GitHubLHAn/Final_DATN_LeHuuAn/Picture/Thực nghiệm/Sơ đồ nguyên lý vdk.png

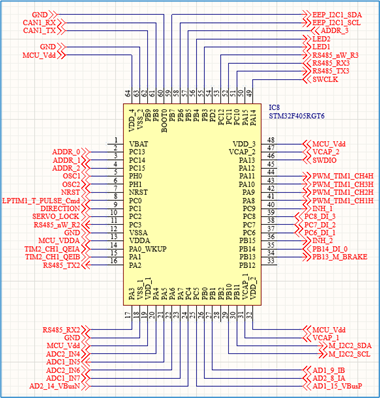
Picture/Thực nghiệm/Sơ đồ nguyên lý vdk.png
