GitHubLHAn/Final_DATN_LeHuuAn/Picture/Thực nghiệm/PCB mặt sau.png

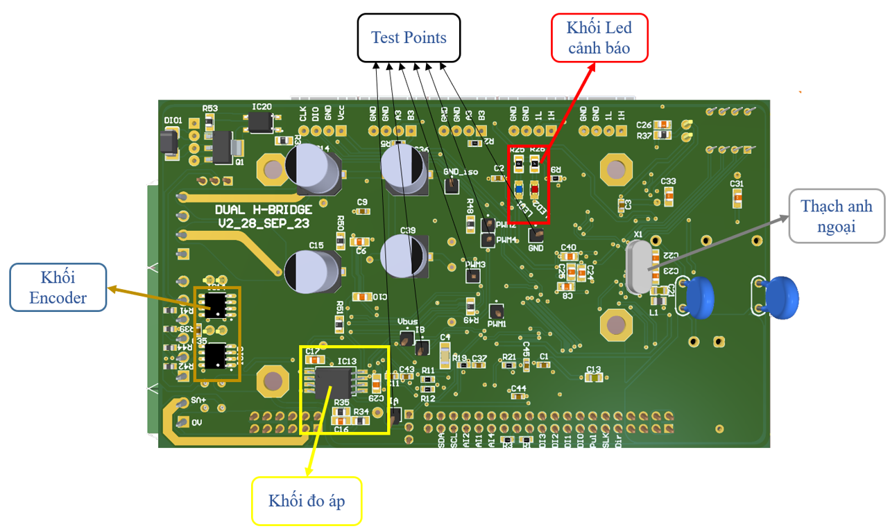
Picture/Thực nghiệm/PCB mặt sau.png
