GitHubLHAn/Final_DATN_LeHuuAn/README.md

# Final_DATN_LeHuuAn
Full final project at university
