GitHubLHAn/Final_DATN_LeHuuAn/Report/Graph_Handmade.pptx

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
North

South

Rotor

## Slide 2

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
North

South

Rotor

## Slide 3

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
North

South

Rotor

## Slide 4

Sin Wave

A

B’

B

A’

+

0

Phase A Current

+

0

Phase B Current

## Slide 5

Static Torque

Displacement from an Equilibrium position

Holding Torque

0

θ_m

θ

## Slide 6

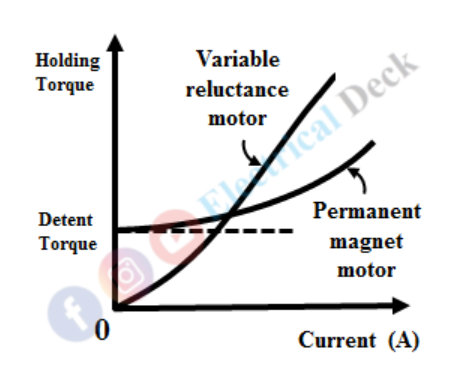
[picture p3: figure]

Holding Torque

Detent Torque

0

Current (A)

## Slide 7

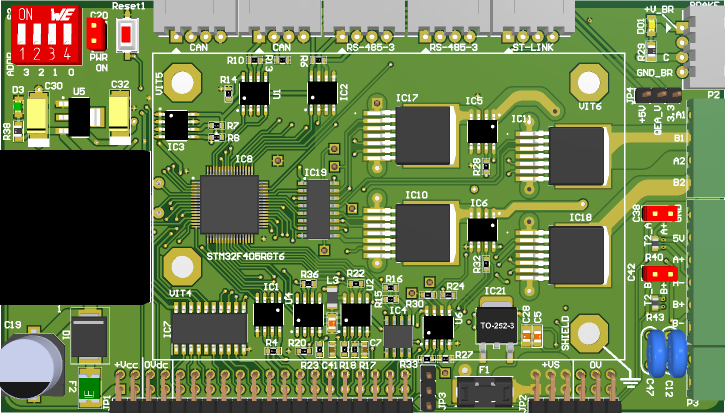
[picture p4: figure]
PCB_5A_HYBRID_SERVO_V3_04_Oct_23

## Slide 8

Mạch điều khiển động cơ

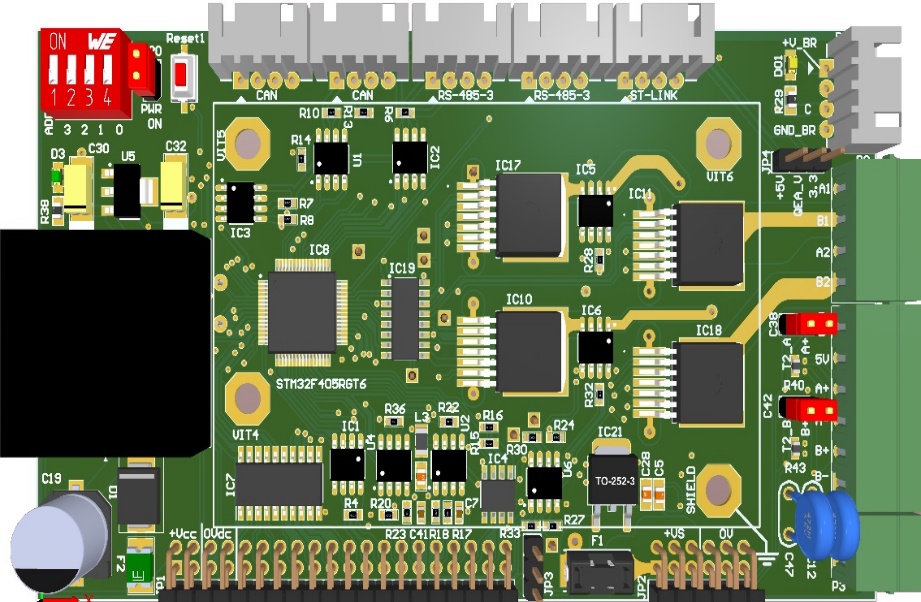
[picture p5: figure]
Ảnh có chứa đồ điện tử, mạch điện, Linh kiện điện, Thành phần mạch điện Mô tả được tạo tự động
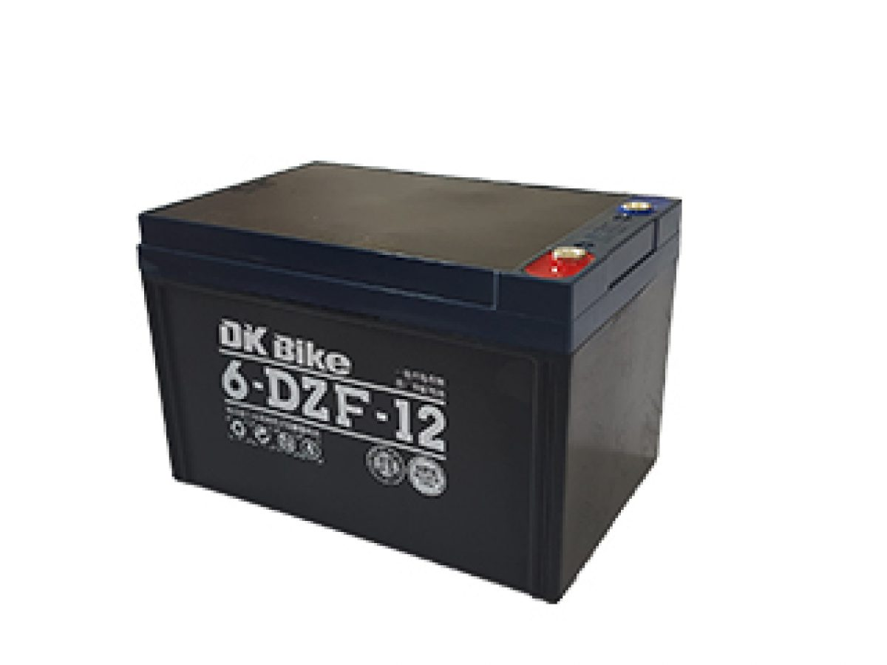
[picture p6: figure]
ẮC QUY XE ĐẠP ĐIỆN DK BIKE 48V - 12AH - Ắc quy nhập khẩu

Pin acqui

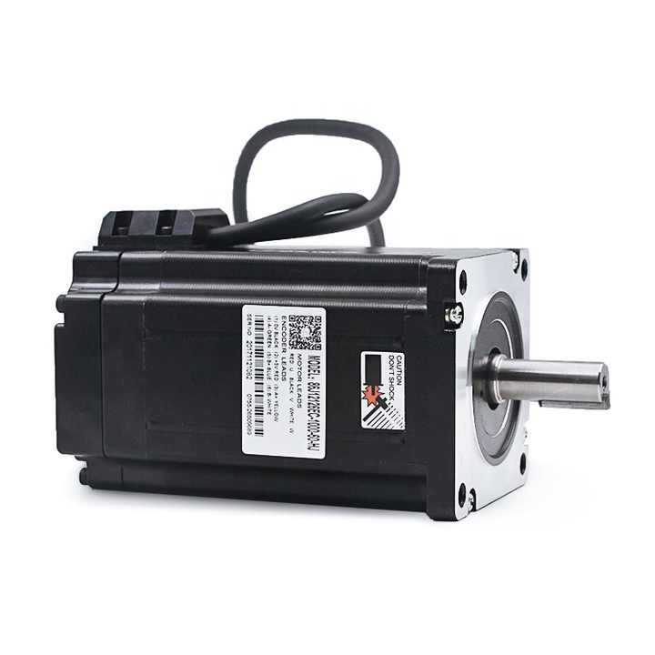
[picture p7: figure]
Source 86J12126EC-1000-60 Động Cơ Servo Bước Hỗn Hợp 1.2 Độ 7.8 N. M Động Cơ Bước Vòng Kín Với Trình Điều Khiển on m.alibaba.com

Hybrid Step Motor

A+

A-

B+

B-

EGND

EA+

EA-

5V

24 Vdc

EB+

EB-

0 Vdc

## Slide 9

Khối Vi Điều Khiển

RS-485

St-Link V2

Khối đo dòng

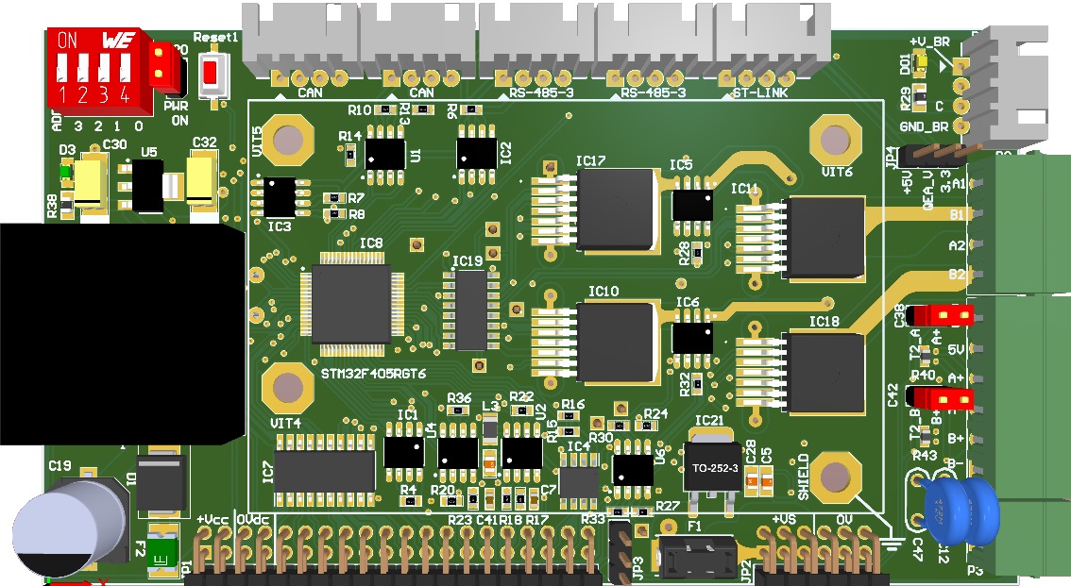
[picture p8: figure]
Ảnh có chứa đồ điện tử, mạch điện, Linh kiện điện, Thành phần mạch điện Mô tả được tạo tự động

Khối nguồn

Đầu ra điện áp động cơ

Cầu đấu Encoder tương đối

Đầu vào ra Analog, I2C,...

Cầu chì phía mạch lực

Khối Driver

## Slide 10

Test Points

Khối Led cảnh báo

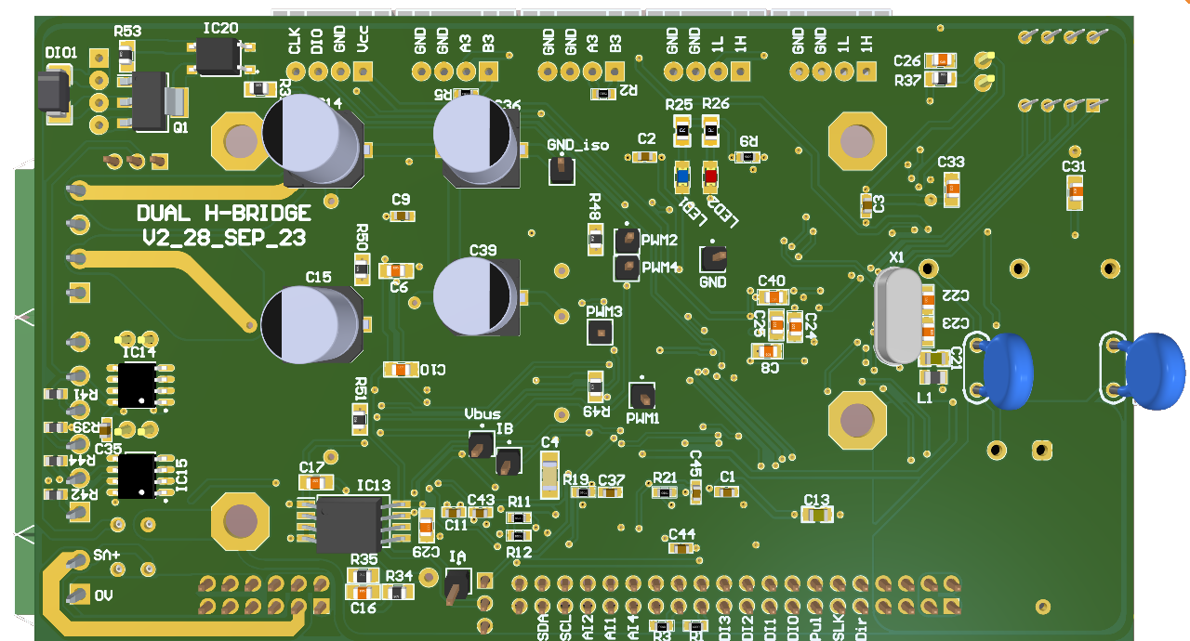
[picture p9: figure]
Ảnh có chứa mạch điện, Kỹ thuật điện, Linh kiện điện, Thành phần mạch điện Mô tả được tạo tự động

Thạch anh ngoại

Khối Encoder

Khối đo áp

## Slide 11

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
## Slide 12

In its simplest form, a step motor consists of a permanent magnet which rotates (the rotor), surrounded by equally spaced windings which are fixed (the stator). Current flow in each winding produces a magnetic field vector, which sums with the field from the other winding. By controlling currents in each winding, a magnetic field of arbitrary direction and magnitude can be produced by the stator. Torque is then produced by the attraction or repulsion between this net stator field and the magnetic field of the rotor.
In field oriented control, the motor input currents are adjusted to set a specific angle between the fluxes produced in the rotor and stator windings. The key to field oriented control is the knowledge of the rotor flux position angle with respect to the stator. The angle between the stator and rotor flux is computed from shaft position. For any position
of the rotor, there is an optimal direction of the net stator field, which maximizes torque; there is also a direction which will produce no torque. If the permanent magnet rotor is in the same direction as the field produces the net stator field, no torque is produced. The fields interact to produce a force, but because the force is in line with the axis of rotation of the rotor, it only serves to compress the motor bearings, not to cause rotation. On the other hand, if the stator field is orthogonal to the field produced by the rotor, the magnetic forces work to turn the rotor and torque is maximized. A stator field with arbitrary direction and magnitude can be decomposed into components parallel and orthogonal to the rotor field. In this case, only the orthogonal (quadrature) component produces torque, while the parallel component produces useless compression forces. For the purpose of control system modeling and analysis, it is convenient to work in terms of winding currents rather than stator magnetic field. This is because motor currents are easily measured externally while fields (flux) are not.
In a step motor, the stator field is produced by current flow in two equally spaced stator windings. These two components sum to produce the net magnetic field of the stator. In order to model the field produced by the stator windings in terms of winding current, ‘current space vectors’ are used. The current space vector for a given winding
has the direction of the field produced by that winding and a magnitude proportional to the current through the winding. This will represent the total stator field as a current space vector that is the vector sum of two current space vector components, one for each of the stator windings.

## Slide 13

The stator current space vector can be broken into orthogonal components in parallel with, and perpendicular to, the axis of the rotor magnet. The quadrature current component produces a field at right angles to the rotor magnet and therefore results in torque, while the direct current component produces a field that is aligned with the rotor magnet and therefore produces no torque. Winding currents will be adjusted so as to produce a current space vector that lies exclusively in the quadrature direction. Torque will then be proportional to the magnitude of the current space vector.
In order to efficiently produce constant smooth torque, the stator space vector should ideally be constant in magnitude and should turn with the rotor so as to always be in the quadrature direction, irrespective of the rotor angle and speed. While the stator current space vector may be constant in magnitude and direction if viewed form the rotating frame of reference of the rotor, from the fixed frame of the stator the current space vector describes a circle as the motor turns. Because the current space vector is produced by the vector sum of components from each of the motor windings, the motor winding currents should ideally be two sinusoids, phase shifted 90 0 from the each other. If winding A and B currents are sine waves phased 90 0 with respect to each other, then the resulting stator magnetic field vector will rotate at the sinusoidal frequency.

## Slide 14

Despite recent performance improvements in step motor modeling and control algorithms, open-loop control still falls significantly short of achieving maximum motor performance. Step motors, which are often used in industrial applications, can exhibit stepping resonance and skipped steps. Field oriented control can eliminate resonance anomalies and skipped steps. The maximum theoretical performance from the step motor can be derived by driving a step motor with field oriented control rather than stepping. In field oriented control, the motor input currents are adjusted to set a specific angle between the stator magnetic field and rotor magnetic field. From basic motor theory, when the stator magnetic field vector is maintained at a phase angle of 90 0 ahead of the rotor magnetic field, maximum torque is produced. The torque varies with the sine of this torque angle between the stator and rotor magnetic field vectors. By sensing rotor position, the phase of the rotor magnetic field can be determined and the current excitation kept 90 0 ahead of it. At this optimal torque angle, maximum torque is available (for given power supply voltage) under steady-state and transient operation. This approach is not widespread because electronic components historically have constrained drives to simple schemes such as stepping, and the full dynamic theory of electric machines was not worked out until the 1980’s. The resulting performance advantages of field oriented control over stepping compensate for the additional circuit cost and complexity.

## Slide 15

emf_a

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
emf_b

x

−

sin

## Slide 16

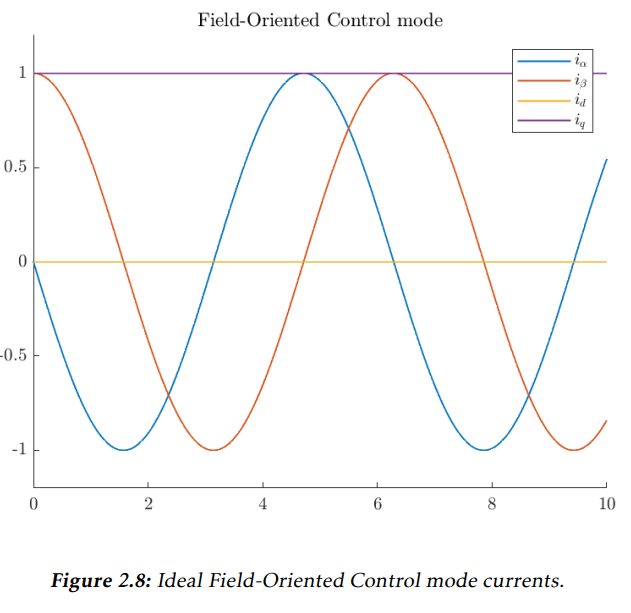
[picture p10: figure]
Ảnh có chứa văn bản, hàng, Sơ đồ, biểu đồ Mô tả được tạo tự động

Holding Torque

i_α

i_β

i_d

i_q

0

## Slide 17

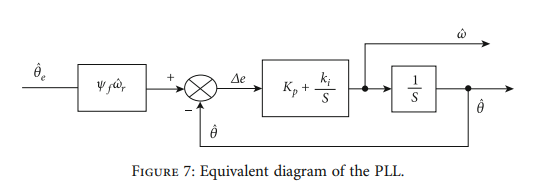
[picture p11: figure]
Ảnh có chứa biểu đồ, bản phác thảo, Phông chữ, Bản vẽ kỹ thuật Mô tả được tạo tự động

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
θ^(∗)

+

PI

1/s

ω

_

θ

## Slide 18

T_s

T_0 /4

T_2 /2

T_1 /2

T_0 /4

T_0 /4

T_1 /2

T_2 /2

T_0 /4

PWMa

PWMb

PWMc

PWMd

Sector I

T_s

T_0 /4

T_2 /2

T_1 /2

T_0 /4

T_0 /4

T_1 /2

T_2 /2

T_0 /4

PWMa

PWMb

PWMc

PWMd

Sector III

T_s

T_0 /4

T_2 /2

T_1 /2

T_0 /4

T_0 /4

T_1 /2

T_2 /2

T_0 /4

PWMa

PWMb

PWMc

PWMd

Sector II

T_s

T_0 /4

T_2 /2

T_1 /2

T_0 /4

T_0 /4

T_1 /2

T_2 /2

T_0 /4

PWMa

PWMb

PWMc

PWMd

Sector IV

## Slide 19

ω^(∗)

+

PI
Controller

i_s^(∗)

Cal

i_q^(∗)

+

−

PI

V_q^(∗)

dq

αβ

V_α^(∗)

Inverter

A +

A -

Hybrid
Step
Motor

V_(ph)

I_(ph)

ω

−

ω

i_d^(∗)

+

−

PI

V_d^(∗)

V_β^(∗)

B +

B -

θ

i_d

αβ

dq

i_q

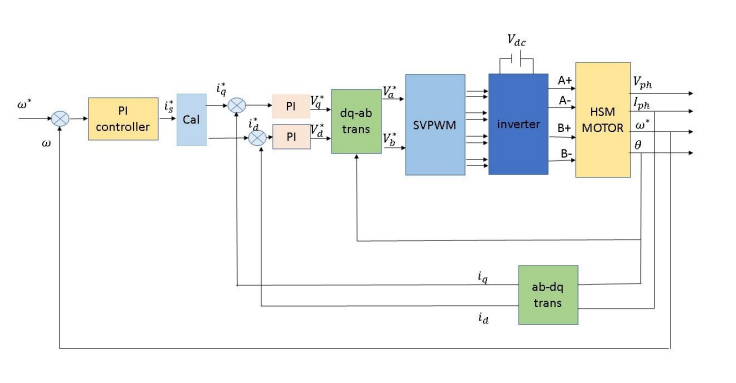
[picture p12: figure]
Ảnh có chứa văn bản, biểu đồ, Kế hoạch, Hình chữ nhật Mô tả được tạo tự động

## Slide 20

Phép tính dòng

i_q^(∗)

+

V_q^(∗)

V_d^(∗)

V_α^(∗)

A +

Động cơ bước lai

V_(ph)

ω^(∗)

+

−

ω

PI

i_s^(∗)

i_d^(∗)

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
V_β^(∗)

Điều chế SVPWM

Mạch Cầu H kép

A -

B +

θ

I_(ph)

ω

−

+

+

emf_d

B -

Ước lượng EMF

emf_q

i_d

αβ

dq

i_q

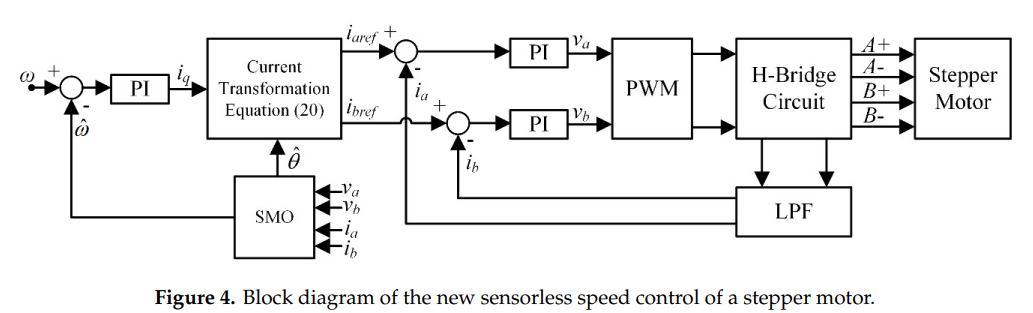
[picture p13: figure]

## Slide 21

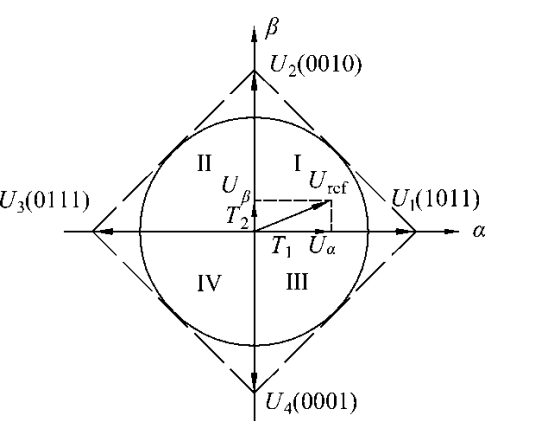
[picture p14: figure]
Ảnh có chứa biểu đồ, hàng, Phông chữ Mô tả được tạo tự động

β

U_2 (0010)

II

U_β

I

U_(ref)

U_3 (0111)

III

T_2

I V

T_1

U_α

U_1 (1011)

α

U_4 (0001)

## Slide 22

i_a^(∗)

V_α^(∗)

Điều chế SVPWM

Mạch Cầu H kép

A +

Động cơ bước lai

ω^(∗)

+

−

ω

PI

i_q^(∗)

Bộ biến đổi dòng điện

i_b^(∗)

Bộ điều khiển trượt (SMC)

V_β^(∗)

A -

B +

B -

θ

i_a

Vòng khóa pha (PLL)

emf_b

emf_a

i_b

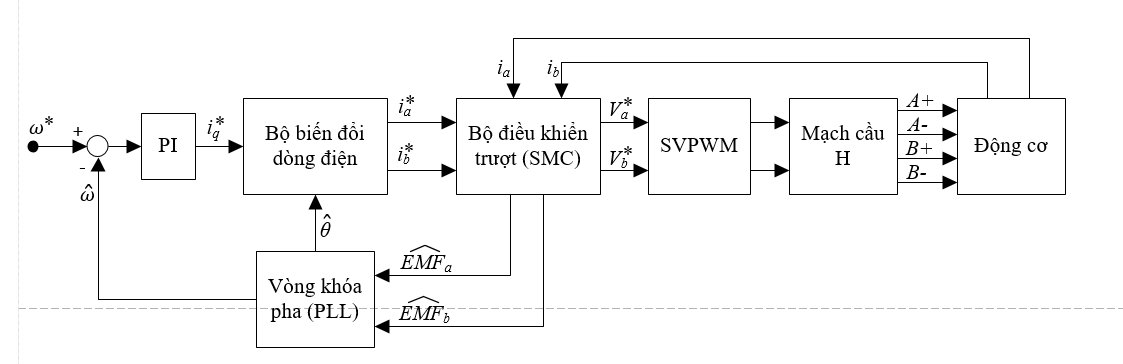
[picture p15: figure]

## Slide 23

x^(∗)

+

R(p)

S_0 (p)

x

−

Hệ thống theo chuẩn tối ưu module

R(s)

PI

S_0 (s)

ω

ω^(∗)

+

−

1/(T_D s+1)

(K_m)/(s.J+B)

Cấu trúc PI cho mạch vòng tốc độ

## Slide 24

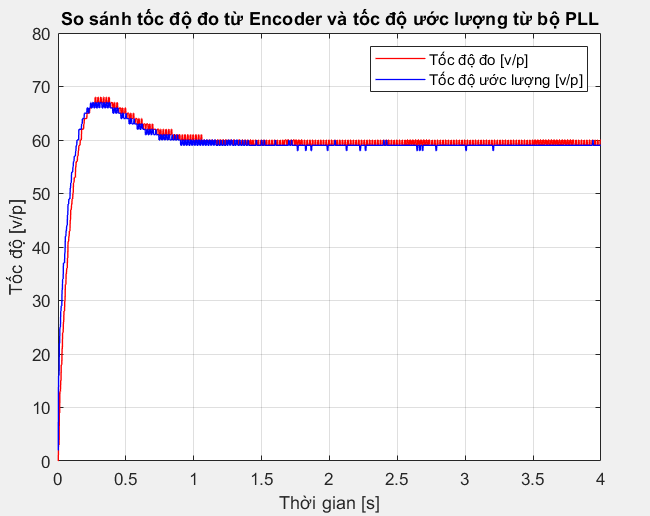
[picture p16: figure]
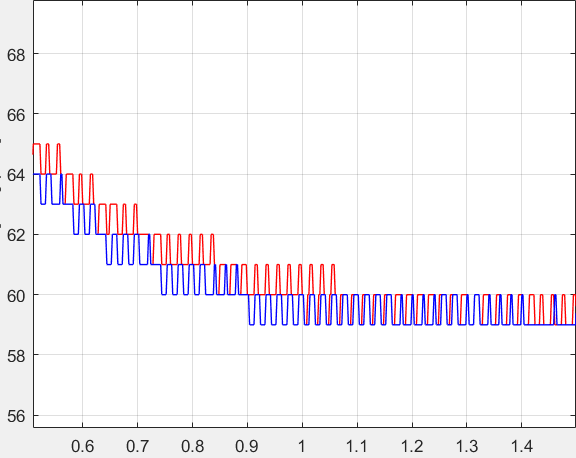
[picture p17: figure]

## Slide 25

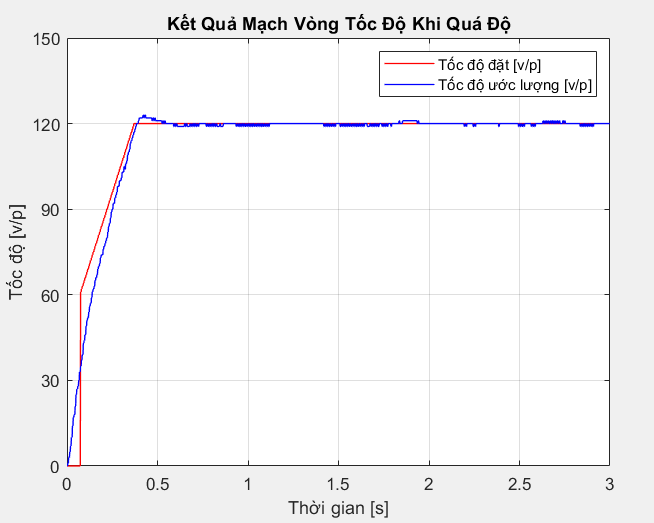
[picture p18: figure]
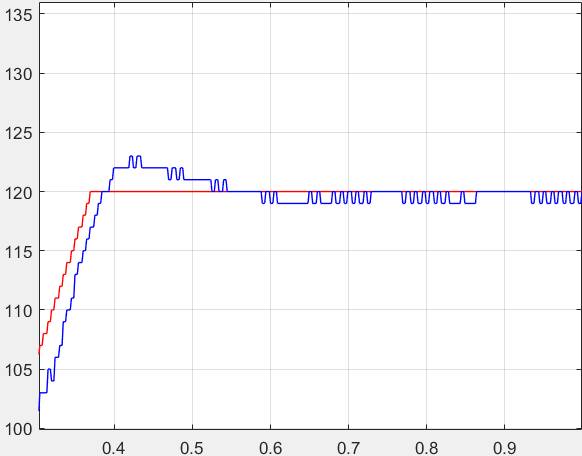
[picture p19: figure]

## Slide 26

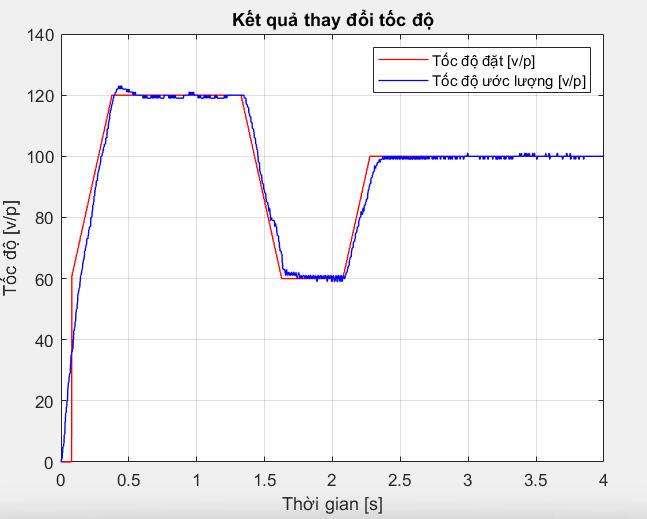
[picture p20: figure]
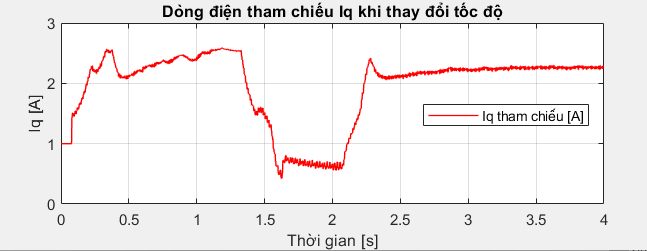
[picture p21: figure]

## Slide 27

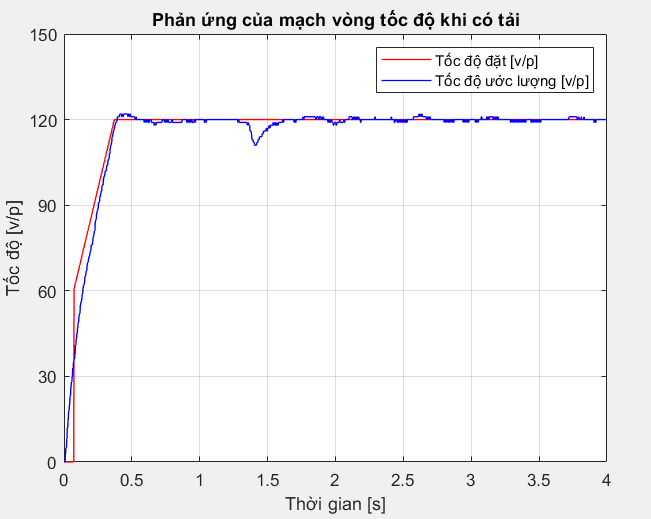
[picture p22: figure]
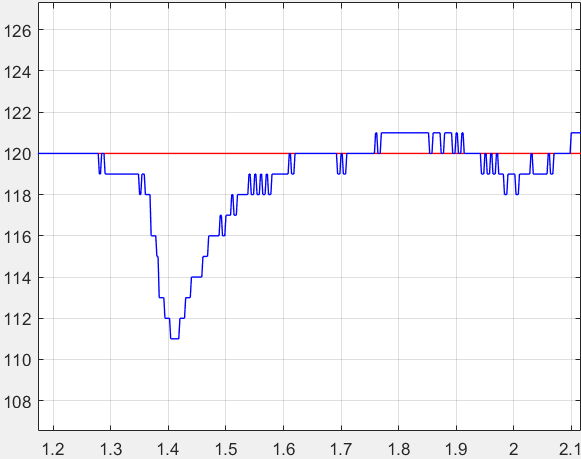
[picture p23: figure]
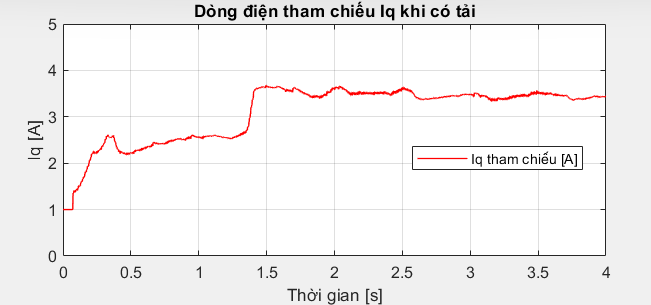
[picture p24: figure]

## Slide 28

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
## Slide 29

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
Cực nam

Cực bắc

Rotor

## Slide 30

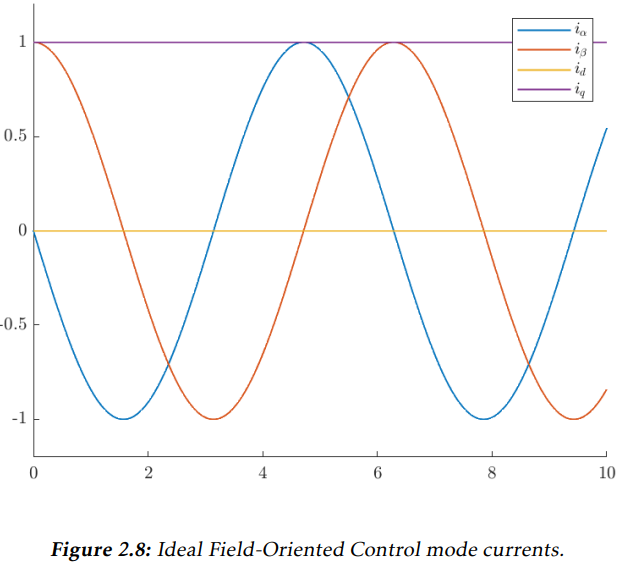
[picture p25: figure]
Ảnh có chứa văn bản, hàng, Sơ đồ, biểu đồ Mô tả được tạo tự động

## Slide 31

## Slide 32

## Slide 33

## Slide 34

## Slide 35
