GitHubLHAn/Final_DATN_LeHuuAn/Code versions/Research/Model_Free/JASE_ModelFreeControlOfOmnidirectionalRobot_V120923.pdf

Submission for JASE

Trajectory Tracking Control of Omnidirectional Mobile Robots: a

Model-Free Control-based Apprroach

Pham Anh Tuan¹ and Nguyen Manh Linh², *

1Hanoi University of Science and Technology. E-mail:tuan.pa192147@sis.hust.edu.vn

2, *Hanoi University of Science and Technology. E-mail: linh.nguyenmanh@hust.edu.vn

Controlling the motion of mobile robots, especially those equipped with Mecanum wheels is challenging due to the existence of disturbances and model uncertainties. In this paper, instead of trying to build a precise model for control design, the model-free control which replaces all the unknown complex mathematical parts with an ultra-local model is chosen. Then, an iPDSMC controller that combines the classical iPD and a double power rate sliding mode controller is proposed to improve the control system performance. The proposed strategy guarantees that even with a low bandwidth extended state observer used to continuously update the unknown parts of the plant, the tracking performance is maintained. The effectiveness of the proposed strategy is verified by both theoretical analysis and numerical simulations

Keywords: Omnidirectional mobile robot; Model-free control; Ultra-local model; Extended-state observer; Sliding mode

control

1

2 | 1. INTRODUCTION
3 | Mobile robots, particularly the omnidirectional ones that are equipped with Mecanum wheels,
4 | have gained widespread adoption in various industries due to their exceptional capabilities.
5 | These robots offer significant advantages, making them highly desirable for numerous appli-
6 | cations. The Mecanum wheel-based mobile robots possess true omnidirectional capabilities,
7 | allowing them to move in multiple directions with ease. This exceptional maneuverability
8 | enables them to navigate through narrow spaces and crowded environments, where conven-
9 | tional wheeled robots would struggle. By effortlessly moving forward, backward, sideways,

Table 1. List of Abbreviations

Abbreviation | Full Form
4-MWMR | Four Mecanum Wheeled Mobile Robot
MPC | Model Predictive Control
MFC | Model Free Control
SMC | Sliding Mode Control
iPD | Intelligent Proportional-Derivative
iPDSMC | Intelligent Proportional-Derivative Sliding Mode
| Control
ULM | Ultra-local Model
ULMFC | Ultra-local Model-free Control
ESO | Extended state observe
LESO | Linear Extended state observe

and even rotating in tight areas, these robots excel in optimizing productivity and efficiency.

These exceptional capabilities have led to the widespread adoption of mobile robots equipped

with Mecanum wheels in various industries, where their applications have been notably

pronounced. These robots have proven to be immensely valuable in warehouse automation

[1], hospital logistics [2], services [3], industrial field [4],. . .

With such practical applications as mentioned above, trajectory tracking has become a

fundamental and essential problem in mobile robot motion control, drawing significant

attention in the field of mobile robot research. Accurate trajectory tracking is of utmost

importance for 4-MWMR, as it directly reflects the effectiveness and performance of the

tracking process.

In literature, control strategies can be roughly categorized into two main types: model-

based and model-free approaches. Model-based control methods rely on mathematical models that describe the dynamics or kinematics of the system being controlled. Based on

the kinematic model, several research papers have proposed control strategies for Mecanum

mobile robots such as PID controller in [5–7] or LQR in [8]. It is worth mentioning that while

the kinematic model-based control strategies provide simplified representations of the robot’s

motion, they disregard the effects of inertia and motor torque limitations, assuming that the

desired velocities will be precisely and instantaneously achieved. However, in the case of

heavier robots or those with less powerful actuators, relying solely on a kinematic controller

may not be adequate. These robots may require additional time to accelerate or may be

limited by their actuator capabilities. Due to the limitations of the kinematic model, many

researchers have developed controllers based on the dynamic model. Prominent examples of

control strategies based on the dynamic model include: MPC controller [9–12], backstepping

control [13–15], and sliding mode control. While the MPC controller can provide robustness

against the model uncertainties and disturbances, it requires an accurate mathematical model

of the plant. And it is important to note that SMC can introduce chattering phenomena,

characterized by high-frequency oscillations around the sliding surface. This chattering effect

can result in increased wear and tear on the actuators and potentially affect the overall system

stability and performance. Numerous studies have been conducted to reduce and eliminate

chattering associated with controlling the 4-MWMR such as super-twisting sliding mode

control [16], adaptive second-order sliding mode [17], nonsingular terminal sliding mode

[18], etc. However, the success of these control methods is strongly governed by the accuracy

of the 4-MWMR’s mathematical model. Neural networks-based control strategies are also

remarkable since the reliance on explicit model assumptions can be minimized [19]. However,

this approach requires a significant amount of data.

To address the challenges of model-based control, a model-free control technique has been developed, with one prominent method that has garnered significant attention ultra-local

model-free control [20, 21]. It works with an ultra-local model continuously updated via

input-output information. The greatest advantage of the ULMFC is that it does not rely on

mathematical models or even ultra-local models during the tuning process of the controller.

Due to the need for continuous updating of the ultra-local model (ULM), various research

studies have employed different methods to address this challenge. Some notable approaches

include: approximated by a piecewise function [21], sliding mode observer [bib22], extended

state observer [22], dual disturbance observers [23], etc. In this paper, we utilize the linear

extended state observer (LESO) [24, 25], a simple yet highly effective observer that can

simultaneously estimate unmodeled dynamics and external disturbances. Moreover, in cases

where estimation errors may occur in the observer, the sliding mode control is employed

to mitigate these discrepancies. In the previous section, we mentioned several improved

methods for the SMC. Although significant improvements have been made in terms of

performance enhancement and reducing chattering phenomena, some of these algorithms

are too complex to be practically implemented. In this research, to strike a balance between

real-world applicability, performance enhancement, and reduction of chattering phenomenon,

the SMC with improved reaching law is adopted and clarified in the subsequent sections.

The remainder of this paper is organized as follows. In section II, we construct a dynamic

model of the 4-MWMR. Next, the process of designing the controller and observer will be

presented in section III. The stability of the controller and observer is carried out in section

IV. Finally, the simulation scenarios and conclusions are conducted in sections V and VI,

respectively.

Table 2. NOMENCLATURE

Symbol | Description

qq =

| xq | yq | ϕ

T
Robot position in inertial frame

q =

xr | yr | ϕ

T
Robot position in body frame
qre f | The reference trajectory
θi | Angular velocity of the ith wheel

τc =

τ1 | τ2 | τ3 | τ4

T
External generalized force generated by four motors

f =

f1 | f2 | f3 | f4

T
Static friction of 4 wheels
Dθ | Wheel’s viscous friction coefficient
Iw | The moment of inertia of the wheel around its center of revolution
Iz | Robot’s moment of inertial around the rotation center
m | Total mass of the FMWMR
R | The radius of Mecanum wheel
a | Half width of the FMWNR
b | Half length of the FMWMR
R(ϕ) | Coordinate Transformation Matrix between Inertial and Body frame
68 | 2. System Description
69 | The mathematical model described here is intended exclusively for simulation purposes and
70 | is not intended for use in controller design.
71 | 2.1. Kinematic of FMWMR
72 | To obtain the kinematic model of the 4-MWMR, we assume that
73 | • The robot moves on a flat horizontal plane
74 | • The 4-MWMR is composed of a rigid body

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

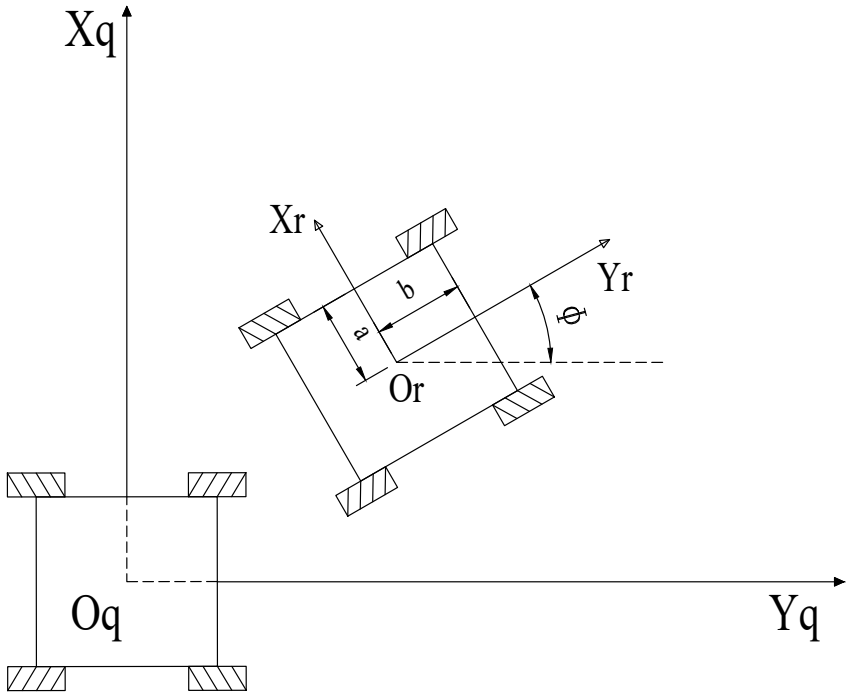
[picture p93: figure]

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

83 | 2.2. Dynamic model of FMWMR
84 | As proposed in [26] and mentioned in [16], the dynamic model of the 4-MWMR can be
85 | expressed based on the Lagrange’s equation as follows:

2(τc − F0) −

∂Dθ ∑

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
q + y˙

2
q
+ Jzϕ˙ ² + Jω ∑i=

˙θi
2

∂θ

−

∂

m
xq

2 + y˙

2
q
+ Jzϕ˙ ² + Jω ∑

4
i=1

˙θ
2
i
∂θ | ,

(7)

86 | In which,
τc = Mθ¨ + Dθθ˙ + F0 | (8)

F0 = f.

sign(θ1) sign(θ2) sign(θ3) sign(θ4)
(9)

M =

C | −B | B | D
−B | C | D | B
B | D | C | −B
D | B | −B | C

(10)

87 With

A =

m · R

2
8

,

B =

Iz · R

2
16 · (W + L)

2

,

C = A + B + IW,

D = A − B

88 | Considering the unknown dynamic disturbances and uncertainties which always exist in
89 | practice, then (8) can be rewritten as:
τc + τd = (M + ∆M)θ¨ + (Dθ + ∆Dθ ) θ˙ + F0 + ∆F0 | (11)

90 | In which, τd, ∆M, ∆Dθ and ∆F0 represent the unknown disturbances. Hence,
τc + τd + Hd = Mθ¨ + Dθθ˙ + F0 | (12)

with Hd = −∆M ¨θ − ∆Dθ

˙
91 | θ − ∆F0.

τd + Hd

92 | is defined as the lumped disturbance in our system. Now, substitute (4) and (5) into
93 | (12), the dynamic model of the 4-MWMR can be obtained after a fundamental manipulation
94 | and described by: q¨ = −
| ζ +(ϕ) ˙ζ(ϕ) + Dθζ +(ϕ)M⁻¹ ζ(ϕ)
| q˙
| + Rζ +(ϕ)M⁻¹ (τc + τd + Hd − F0) (13)
95 | where,

q =

xq yq Φ

T
(14)

ζ

+(ϕ) = 1
4

√
2 cos(ϕa) −

√
2 sin(ϕa)

√
2 cos(ϕa) −

√
2 sin(ϕa)
√
2 sin(ϕa)

√
2 cos(ϕa)

√
2 sin(ϕa)

√
2 cos(ϕa)

1

a+b | − 1
a+b | − 1
a+b

1
a+b

(15)

ζ =

√
2 cos(ϕa)

√
2 sin(ϕa) a + b

−

√
2 sin(ϕa)

√
2 cos(ϕa) −(a + b)
√
2 cos(ϕa)

√
2 sin(ϕa) −(a + b)

−

√
2 sin(ϕa)

√
2 cos(ϕa) a + b

(16)

˙ζ = ϕ˙

−

√
2 sin(ϕa)

√
2 cos(ϕa) 0

−

√
2 cos(ϕa) −

√
2 sin(ϕa) 0

−

√
2 sin(ϕa)

√
2 cos(ϕa) 0

−

√
2 cos(ϕa) −

√
2 sin(ϕa) 0

(17)

96 | Since the model-free controller is employed in this research, the control design is not based
97 | on the dynamic model (13). However, the performance of the controller that going to be
98 | designed must be verified by using (13).

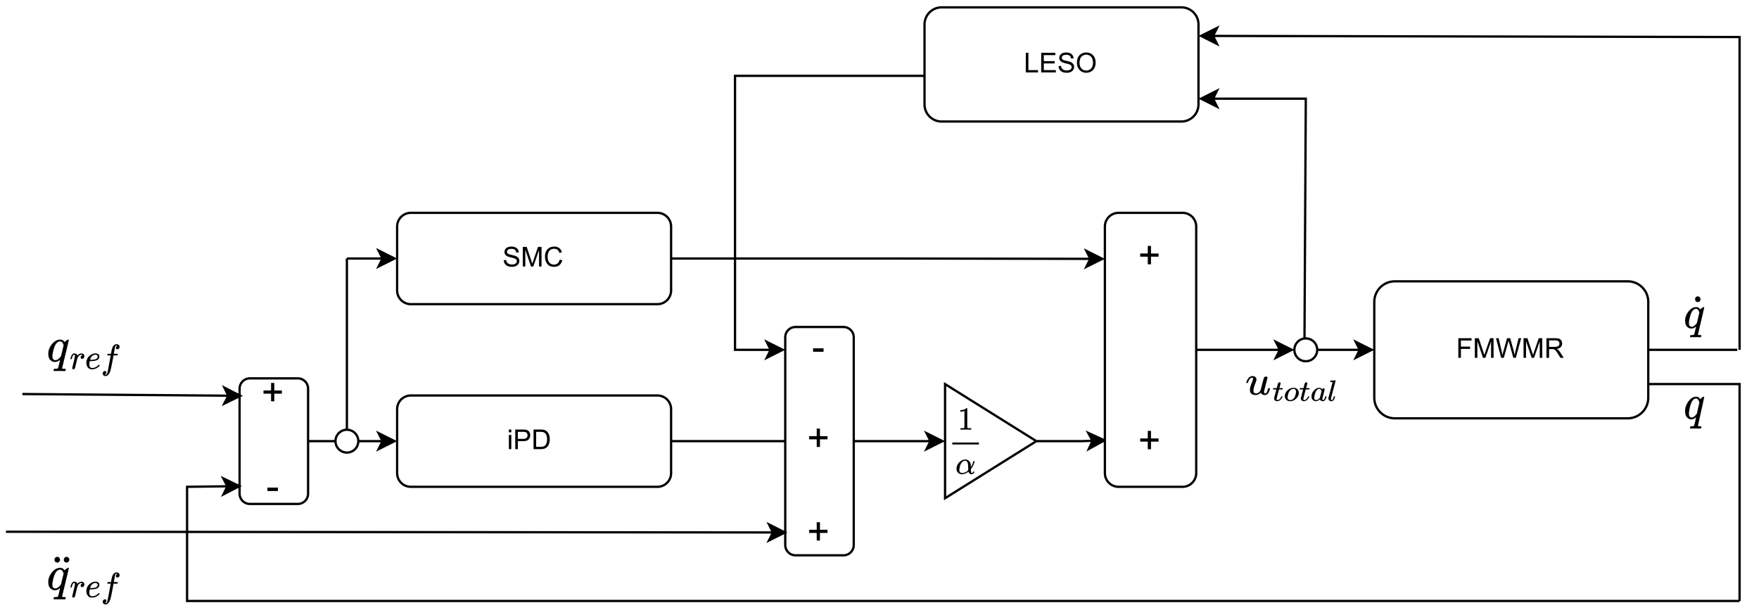
[picture p94: figure]

Fig. 2. Control scheme of the proposed MFC

3. Control Design

In this section, the MFC design is presented. The block diagram of the proposed MFC is

shown in Fig. 2, which consists of a LESO that can simultaneously estimate unmodeled

dynamics and external disturbances, an iPD controller to track the reference trajectory, and an

SMC to mitigate the remaining estimation errors. The control design of the proposed control

system is carried out in the next subsections.

3.1. Ultra-local model-free control: general principles

The main concept of the ultra-local model-free is using a local model that is continuously

updated via a control signal and the system’s output. Consider the following dynamic

equation:

y

(v) = F + α.u | (18)

in which,

- v is the derivative order of y, which needs to be selected appropriately for the plant. In

our implementation v = 2

- α is a constant which must be tuned appropriately
- F encompasses the plant’s unmodeled dynamics, uncertainty, and external disturbances

114 | • u is the control signal
115 | Since the goal of our research is trajectory tracking control, (18) is rewritten as:
q¨ = F + αu | (19)
116 | Define e as the tracking error, which means
e = qre f − q | (20)
117 | Based on the ultra-local model [20], an iPD controller is employed as following:

u =

1

α

(Kpe + KDe˙ + q¨re f − Fˆ) | (21)
118 | where Kp and KD are positive gains.
119 | By substituting (21) into (19), it can easily be deduced that
e¨ + Kpe + KDe˙ = Fˆ − F | (22)
120 | or
e¨ + Kpe + KDe˙ = F˜ | (23)
121 | In which,
- Fˆ 122 | is the estimation of F using an extended state observer that is going to be discussed
123 | in the next subsection.
124 | • F˜ = Fˆ − F is the estimation error
It can be realized from (23) that if the observer is perfect, i.e., 125 | F˜ ≈ 0, then the dynamic of the
126 | tracking error can be described by
e¨ + Kp.e + KD.e˙ = 0 | (24)
127 | Meaning that the tracking performance is now only dependent on Kp and KD of the iPD
128 | controller.

3.2. Linear Extended State Observer Design

As has been discussed, the disturbance observer plays an essential role in affecting the

quality of the control system. Hence, this subsection focuses on the observer design. The

Extended state observer (ESO) was initially introduced by Han [24] as a component of the

ARDC, which is capable of simultaneously estimating unmodeled dynamics, parameter

uncertainties, and external disturbances by treating them as a lumped perturbation. The

robustness and outstanding performance of the non-linear extended state observer have

attracted significant attention from researchers and have been validated through practical

applications. However, one disadvantage of this observer is that the tuning of multiple

parameters is complicated. To address this issue, Gao [25] proposes to use linear feedback

rather than non-linear feedback, resulting in the development of the LESO in which only one

parameter, i.e., the observer’s bandwidth ω0, needs to be adjusted. In our research, the LESO

is adopted to estimate the lumped disturbance F. In detail, define the state variables as:

x1 = q˙

x2 = F

(25)

Define f and ˙
f are the first and the second order differentiation of the unknown lumped

disturbance F, i.e., f = F˙ and ˙
f = F¨ 143

Assumption 1: There exists positive number ε1 and ε2 such that f and its differentiation ˙ f are

bounded by

||f|| ≤ ε1 | (26)

|| ˙
f|| ≤ ε2 | (27)

146 | Base on (25), (19) can be rewritten in state-space form as:
| x˙1 = x2 + αu
| x˙2 = f

(28)

147 | Since we can directly measure x1 = q˙ by an encoder in practice, the LESO can be designed as:
| ˙xˆ1 = xˆ2 + α.u + β1.(x1 − xˆ1)
| ˙xˆ2 = β2(x1 − xˆ1) (29)
In (29), xˆ1 = ˙ 148 | qˆ and xˆ2 = Fˆ are the estimation of q˙ and F, respectively. The two remaining
149 | parameters β1 and β2 are the observer’s gains that must be tuned appropriately. Now,
150 | subtract (29) from (28), the estimation error can be formulated by:
| ˙x˜ 1 = x˜2 − β1x˜1
| ˙x˜ 2 = f − β2x˜1 (30)
151 | Differentiate both sides of (30), a fundamental manipulation yields:

¨x˜ 1 + β1

˙x˜ 1 + β2x˜1 = f

¨x˜ 2 + β1

˙x˜ 2 + β2x˜2 = β1 f + ˙
f

(31)

152 | Since x˜1, x˜2 and f are the same size, i.e., [3 × 1], a simple Laplace transformation on both
153 | sides of (31) gives x˜1,i fi =
| 1 p 2 + β1 p + β2 x˜2,i β1 fi + ˙ fi =
| 1 p 2 + β1 p + β2 (32)
154 | In which, i = [1, 2, 3] and p is the Laplace operator. Now, based on (32) and taking assumption
155 | (27) into account, the following two conclusions can be drawn.
156 | First, the stability and the dynamic of the LESO can be guaranteed by tuning the parameters
157 | of the following characteristic equation

p

2 + β1 p + β2 = 0 | (33)

Since (33) represents a second-order linear dynamic system, a simple method that ensures

the stability of (32) is selecting β1 and β2 as

β1 = 2ω0, β2 = ω

2
0

(34)

where ω0 is the bandwidth of the LESO. Then, the estimation error of the LESO in steady-state

is

x˜1i,s = lim
p→0

fi
p

2 + β1 p + β2

=

fi
ω2
0

x˜2i,s = lim
p→0

β1 fi + ˙
fi
p

2 + β1 p + β2

=

2ω0 fi + ˙
fi
ω2
0

(35)

Second, by taking (27) and (35) into consideration, it can be concluded that the LESO’s

estimation error is bounded by

|x˜1i,s

| ≤ ε1
ω2
0

|x˜2i,s

| ≤ 2ω0ε1 + ε2
ω2
0

(36)

3.3. Model-free Sliding Mode Control Design

As seen in (24), the iPD controller can perform well as the LESO is perfect. However,

sensitivity to measurement noise as well as high sampling rate requirement which needs

more powerful hardware are two major issues when a large bandwidth ω0 is chosen in

practice. Nevertheless, if a lower bandwidth is selected, the LESO estimation error increases

as pointed out in (36), and following that the performance of the simple iPD-based model-free

control is degraded. Hence, an additional SMC is proposed to suppress the influence of this

remaining estimation error. The control design of the SMC is presented in this section, in

detail.

The traditional SMC law usmc is comprised of two fundamental components: an equivalent

control signal and another switching term. The equivalent control action ueq is responsible for driving the system’s states towards the sliding surface, which is a hyperplane that separates

the desired and undesired states of the system. On the other hand, the switching control

term usw ensures that the system’s states remain on the sliding surface, which is essential

for achieving stability and robustness in the control system. However, the problem of

chattering is an inherent limitation that hinders the widespread adoption of the SMC. In this

section, a model-free SMC using the double power reaching law in combination with ULM is

designed. This approach not only guarantees that the sliding surface is quickly reached but

also effectively reduces the chattering phenomenon. Now, consider the following SMC signal

usmc = ueq + usw | (37)

By augmenting the existing iPD controller (21) with an additional control signal usmc, it yields

u =

1

α

(Kpe + KDe˙ + q¨re f − Fˆ) + usmc | (38)

Substitute (38) into (19), then the dynamic of the tracking error is

e¨ + αusmc + Kpe + KDe˙ = F˜ | (39)

Chose the sliding surface s as follows:

s = e˙ + λe | (40)

In which, λ is a positive constant. Then, by taking the derivative on both sides of (40), it gives

s˙ = e¨ + λ.e˙ | (41)

Now, by extracting e¨ from (39) and substituting it into (41), the dynamic of the sliding surface

can be represented by

s˙ = F˜ − (αusmc + Kpe + KDe˙) + λe˙ | (42)

The equivalent control signal ueq can be found by solving (42) in the case of s˙ = 0 and

neglecting the unknown term F˜ 190 | . As a result

ueq =

1

α

[−Kpe + (λ − KD)e˙] | (43)

In SMC design, there are plenty of reaching laws that have been proposed in the literature

to cope with the uncertainties. Among such proposed methods, the double power rate law

exhibits several advantages such as faster reaching speed and less chattering. Hence, this

approach is chosen in this research. Considering the following switching control signal

usw =

k1

α

.|s|

.γ

.sign(s) + k2

α

.|s|

.β
.sign(s) | (44)

with (k1, k2 > 0), γ > 1, 0 < β < 1. Besides, .|s|

.γ
, .sign(s) mean element-wise operation.

Substitute (43), (44) into (42) with consideration of (37), it gives

s˙ = F˜ − k1.|s|

.γ
.sign(s) − k2.|s|

.β
.sign(s) | (45)

In (45), the two terms k1.|s|

.γ
.sign(s) and k2.|s|

.β
.sign(s) respectively play a dominant role

as |s| > 1 and |s| < 1, while the influence of the remaining part is weakened. Due to this

characteristic, this law guarantees a consistently fast-reaching speed for the control system.

Finally, by taking summation of (43) and (44), the final employed SMC law is

usmc =

1

α

[−Kpe + (λ − KD)e˙ + k1.|s|

.γ
.sign(s) + k2.|s|

.β
.sign(s)] | (46)

And the final control signal is obtained by substituting (46) into (38), which results in

u =

1

α

[q¨re f + λe˙ + k1.|s|

.γ
.sign(s) + k2.|s|

.β
.sign(s) − Fˆ] | (47)
4. Stability analysis

First, the stability of the LESO is guaranteed by (34). Then, the stability of the control system

is actually dependent on (45). Considering the following candidate Lyapunov function:

V =

1
s

T
s | (48)

Differentiate both sides of (48) and take (45) into account, it yields

V˙ = s

T
s˙

= s

T
(F˜ − k1.|s|

.γ
.sign(s) − k2.|s|

.β
.sign(s))

(49)

Equation (49) can be rewritten in detail as

V˙
i = si

[

˜
fi − k1|si
γ

sign(si) − k2|si

β
sign(s)]; with i = (1, 2, 3)

(50)

As previously discussed, the reaching phase of the double power reaching law can be divided

into two regions, corresponding to |si

| > 1 and |si

| ≤ 1. In the former region, k1|si

γ

sign(si)

is dominant while k2|si

β
sign(s) is essential in the latter one. Therefore, the stability analysis

can also be performed in those two regions respectively.

First, suppose that si > 1, then (50) can approximately represented by

V˙
i ≈ si

[

˜
fi − k1s

γ
i
] | (51)

As referred from (36), |

˜
fi

| = |x˜2i,s

| ≤ 2ω0ε1+ε2
ω2
0

. Then (51) fulfills

V˙
i ≈ si

[

˜
fi − k1s

γ
i

]

< si

[

2ω0ε1 + ε2
ω2
0

− k1s

γ
i

]

| (52)

Inequality (52) shows that the stability of the control system in this phase can be guaranteed

by choosing k1 so that V˙
i < 0 for all si > 1 and γ > 1. Therefore,

k1 > max[

1
s

γ
i

(

2ω0ε1 + ε2
ω2
0

)]

→k1 >

2ω0ε1 + ε2
ω2
0

(53)

Similarly, consider the situation where 0 < si,min < si < 1, in which 0 < si,min << 1 is a small

expected boundary. Then (50) can be reformulated by

V˙
i ≈ si

[

˜
fi − k2s

β
i
] | (54)

217 | To guarantee the stability of the control system in this case, k2 must be selected such that
| V˙
218 | i < 0. Consequently,
| k2 > max ˜
| fi
| s β
| i
| →k2 > [
| 1
| s β
| i,min ( 2ω0ε1 + ε2
| ω2
| 0 )] (55)

By chosing k1 and k2 according to (52) and (55), V˙
219 | i < 0 is also true in the case where si < −1
220 | and −1 < si < −si,min < 0, respectively. This means the sliding variable si approaches a
221 | small vicinity [−si,min,si,min] asymptotically. As a result, the stability of the control system is
222 | guaranteed and the chattering phenomenon is restricted in a small region [−si,min,si,min].
223 | 5. Numerical simulations and discussions

Table 3. System’s Parameters

Symbol | Description | Symbol | Description
a | 0.3(m) | b | 0.3(m)
m | 40(kg) | R | 0.075(m)
I | 6(N·m) | fi | 10(N)
Dθ | 0.2 | λ | 3
k1 | 0.8 | k2 | 0.8
α | 1.2 | β | 0.6
ω0 | 100(rad/s)
224 | In this section, various numerical simulations are carried out to determine the effectiveness
225 | of the proposed trajectory-tracking control system. The parameters of the 4-MWMR and
226 | the controller are provided in Table 3. Two typical references including step and circular
227 | trajectories are employed in simulations. In addition, the proposed controller is also compared

228 | with the iPD controller and the classical SMC to show a more comprehensive evaluation.
229 | Define the reference trajectory qre f as

qre f =

xre f(t)

yre f(t)

ϕre f(t)

(56)

230 Then, a step change trajectory can be described by

xre f =

0, t < 10

0.1(t − 10), t ≥ 10

yre f =

0.1t, t < 10

1, t ≥ 10

ϕre f =

0, t < 10

0, t ≥ 10

(57)

231 | This means the 4-MWMR moves along the y axis in the first 10 seconds and turns right
232 | suddenly after that without rotating its body.
233 | The employed circular trajectory is represented by

qre f =

xre f(t)

yre f(t)

ϕre f(t)

=

0.6sin(0.2t)(m)

0.6cos(0.2t)(m)

0.6sin(0.2t)(rad)

(58)

234 | In the first scenario, simulations are conducted under ideal conditions where all parameters
235 | are constant and no modeling errors, as well as disturbances, exist. Simulation results with
236 | step and circular reference trajectories are shown in Fig. 3 and Fig 4, respectively.
237 | By observing the above-mentioned results, it can be seen that all three controllers in-
238 | cluding iPD, SMC, and iPDSMC can drive the 4-MWMR to track the reference trajectories

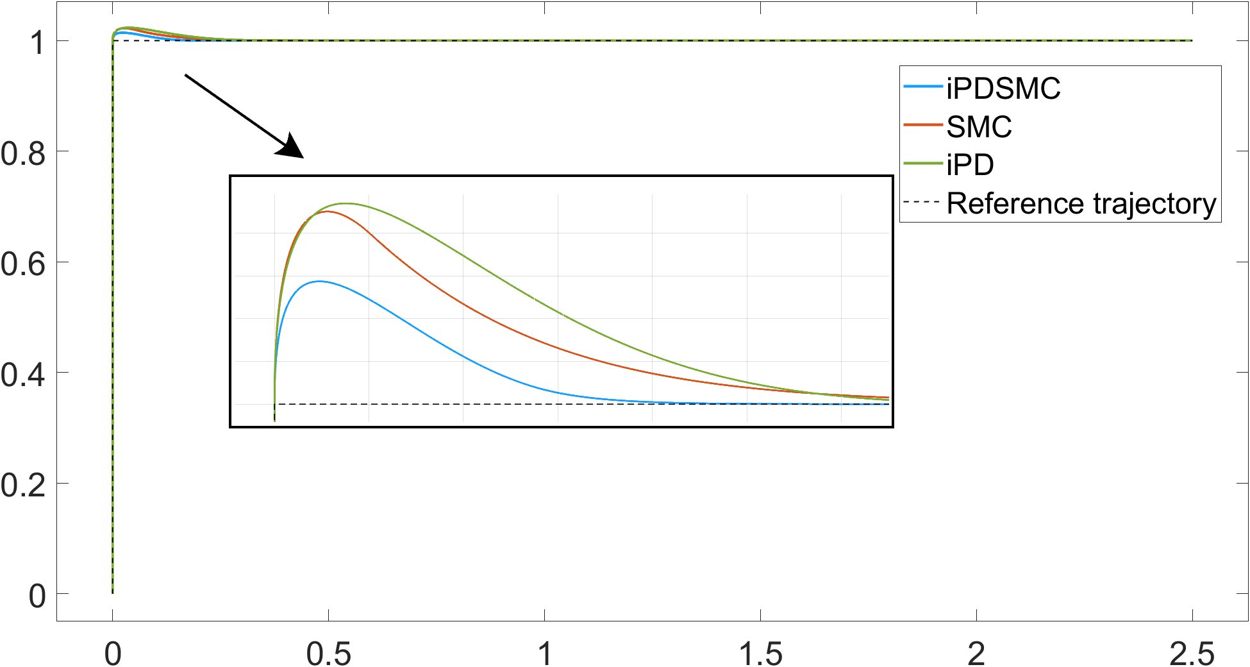
[picture p95: figure]

Fig. 3. Tracking performance under ideal conditions with step trajectory

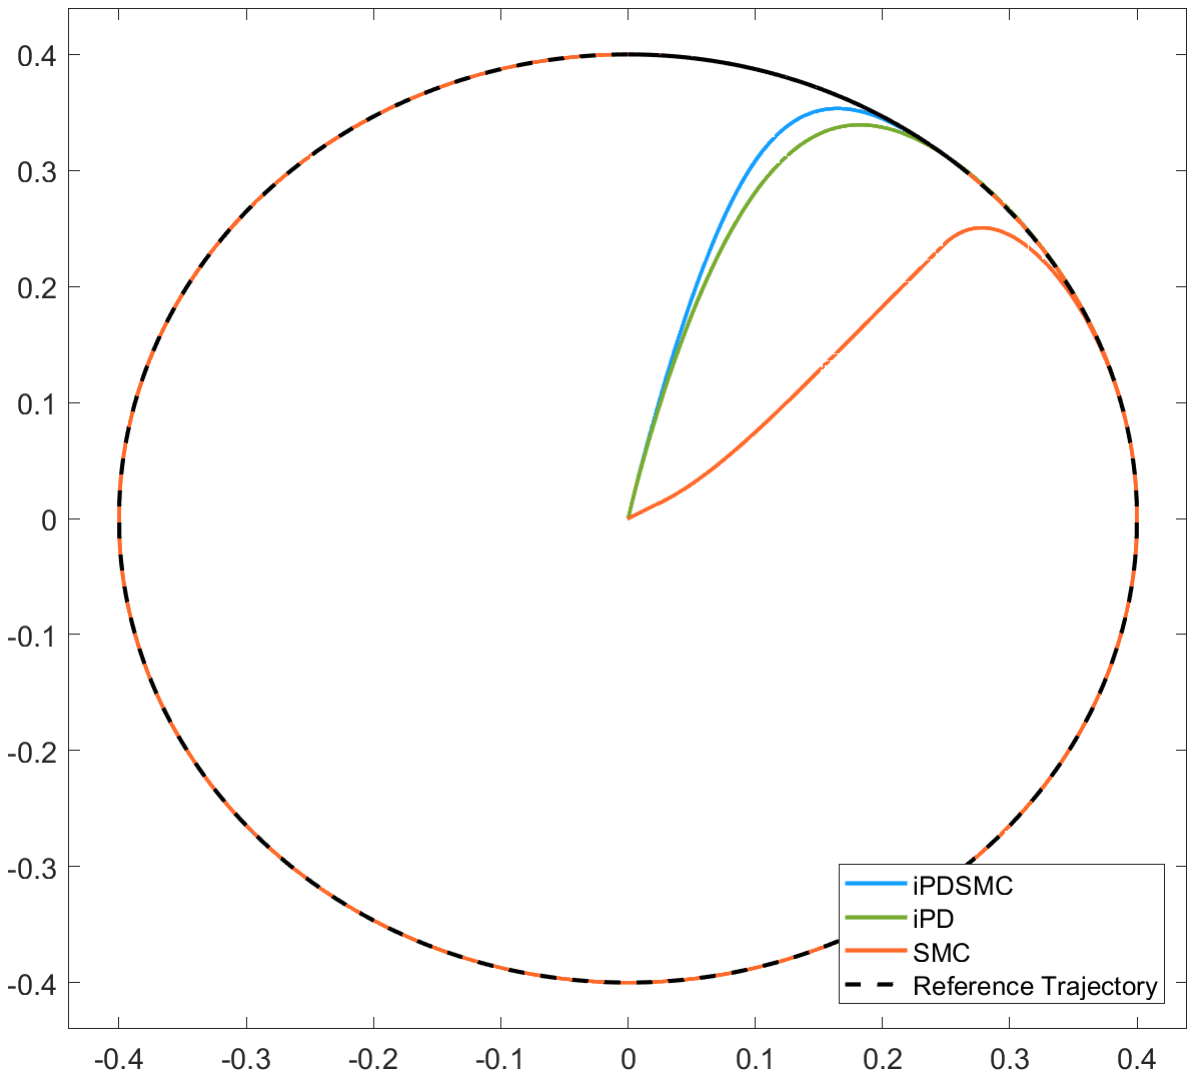
[picture p96: figure]

Fig. 4. Tracking trajectory under ideal condition with circular trajectory

239 | asymptotically. In addition, none of the three controllers exhibit steady-state errors.
240 | In the second scenario, simulations are conducted under the influence of the following
241 | lumped disturbance

τd =

0.5sin(2t) 0.5cos(2t) 0.5sin(2t) 0.5 ∗ cos(2t)

T
(59)
242 | Simulation results shown in Fig. 5 and Fig. 6 indicate that under the affection of the
243 | unmatched disturbance (36), the classical SMC is no longer able to control the 4-MWMR to

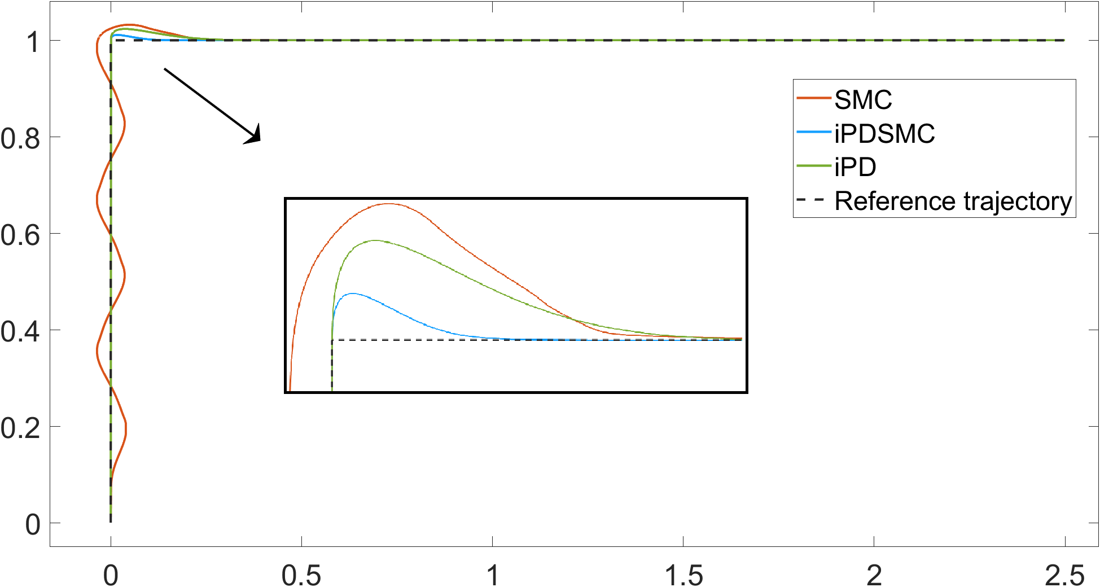
[picture p97: figure]

Fig. 5. Tracking performance with step trajectory under disturbance

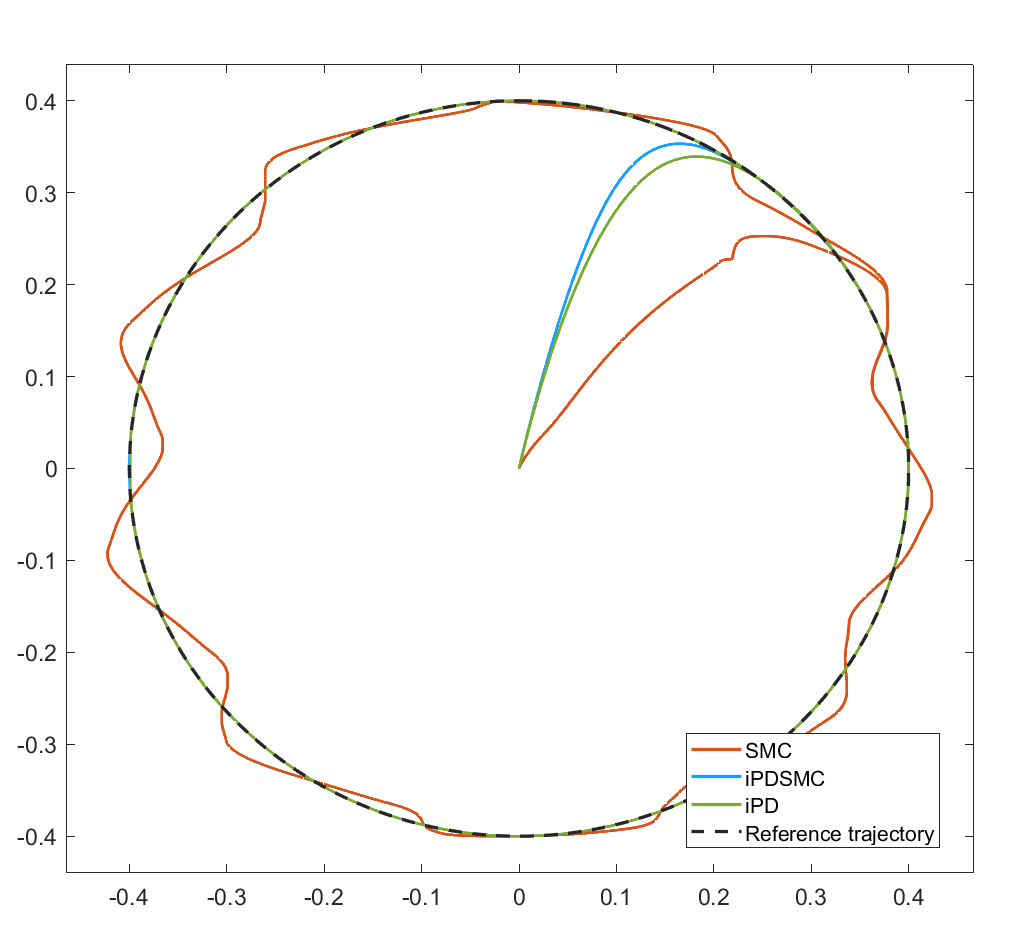
[picture p98: figure]

Fig. 6. Tracking performance with circle trajectory under disturbance

244 | track the reference trajectory in both cases. In contrast, both iPDSMC and iPD controllers
245 | still perform well without steady-state error. Both above simulation results show that there
246 | is no remarkable difference between the iPD and the iPDSMC-based model-free control in
247 | terms of tracking performance. The main reason is that the bandwidth ω0 of the LESO is
248 | sufficiently large, i.e., 100(rad/s), so that the estimation error of the LESO can be neglected.

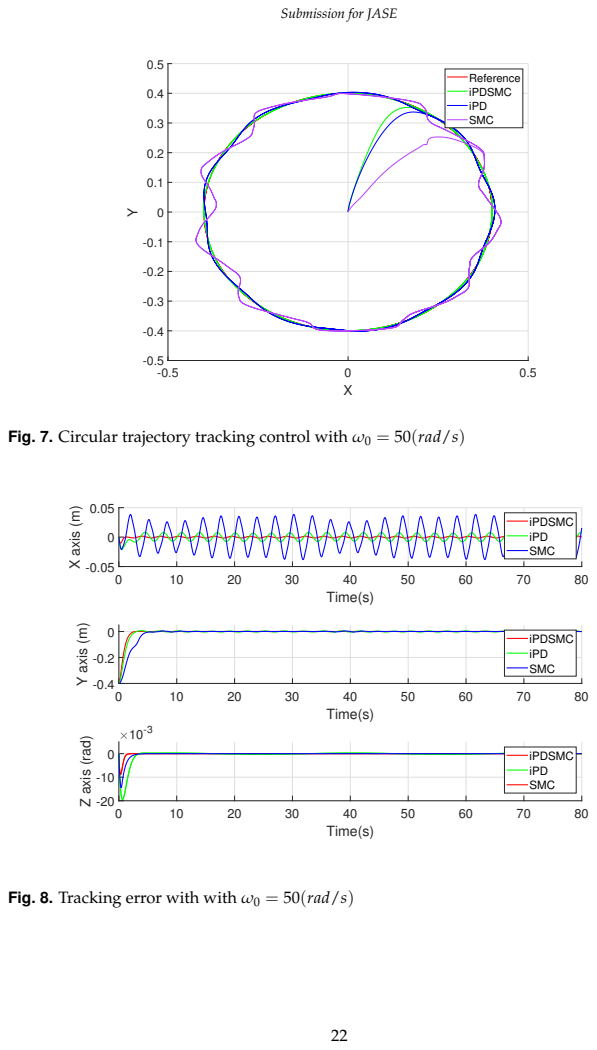
[picture p99: page 22]
Time(s); X axis (m); Y axis (m); Z axis (rad)

Reference iPDSMC

iPD SMC

Fig. 7. Circular trajectory tracking control with ω0 = 50(rad/s)

iPDSMC iPD

SMC

Fig. 8. Tracking error with with ω0 = 50(rad/s)

To show the advantage of the proposed iPDSMC over the classical iPDSMC, simulations

with a lower bandwidth, i.e., ω0 = 50(rad/s) are conducted, and the results are shown in Fig.

7 and Fig. 8. It can easily be seen that the tracking performance of the iPD controller degrades

significantly as ω0 decreases. In contrast, the proposed iPDSMC maintains its performance

with unnoticeable changes.

6. CONCLUSIONS

In this research, the trajectory tracking control problem of a 4-MWMR based on the model-

free control strategy is presented. This approach eliminates the time-consuming effort that

is used to build a precise mathematical model for control design. Theoretical analysis is

carried out, which shows that the performance of the control system not only depends on

the parameters of the classical iPD controller but also the bandwidth of the LESO which

continuously updates the unknown lump disturbances. Then, an iPDSMC control strategy

is proposed to guarantee the balance between measurement noise immunity, hardware cost,

and control system performance. Numerical simulations show that at low LESO bandwidth,

the proposed strategy performs much better than the classical iPD controller in terms of

tracking accuracy. This contribution is meaningful in practice since a low LESO bandwidth

gives the control system the ability to reject the high-frequency noise influences. Besides, the

cheaper controllers can be used due to the fact that the sampling rate of the control system

can be diminished along with the bandwidth.

Conflicts of Interest: The author declares no conflict of interest.

Acknowledgment

This research is funded by the Hanoi University of Science and Technology (HUST) under

project number T2022-PC-005.

272 | References
273 | [1] K. Jayabalan, Sangeetha, B. Tanneru, H. Prasad, and V. Mukkoti, (2017) “A Mecanum
274 | Wheel Based Robot Platform for Warehouse Automation" International Journal of Mechan-
275 | ical Engineering and Technology 8: 181–189.
276 | [2] Y. Shi, A. Hayat, V. Sivanantham, and R. E. Mohan, (2021) “WaspL: Design of a Reconfig-
277 | urable Logistic Robot for Hospital Settings":
278 | [3] B. Clemons, I. Ferdyan, and K. Anderson, (2022) “The Development of E-Butler Hotel
279 | Service Robot" Engineering, MAthematics and Computer Science (EMACS) Journal 4:
280 | 67–72. DOI: 10.21512/emacsjournal.v4i2.8119. (https://doi.org/10.21512/emacsjournal.v4i2.8119)
281 | [4] R. Galati, G. Mantriota, and G. Reina, (2022) “Adaptive heading correction for an industrial
282 | heavy-duty omnidirectional robot" Scientific Reports 12: DOI: 10 . 1038 / s41598 - 022 - (https://doi.org/10.1038/s41598-022-24270-x)
283 | 24270-x. (https://doi.org/10.1038/s41598-022-24270-x)
284 | [5] A. Ma’arif, N. Raharja, G. Supangkat, F. Arofiati, R. Sekhar, and D. Rijalusalam, (2021)
285 | “PID-based with Odometry for Trajectory Tracking Control on Four-wheel Omnidirectional
286 | Covid-19 Aromatherapy Robot" Emerging Science Journal 5: 157–181. DOI: 10.28991/esj- (https://doi.org/10.28991/esj-2021-SPER-13)
287 | 2021-SPER-13. (https://doi.org/10.28991/esj-2021-SPER-13)
288 | [6] N. Hong Thai, T. Ly, and L. Dzung, (2022) “Trajectory tracking control for mecanum wheel
289 | mobile robot by time-varying parameter PID controller" Bulletin of Electrical Engineering
290 | and Informatics 11: 1902–1910. DOI: 10.11591/eei.v11i4.3712. (https://doi.org/10.11591/eei.v11i4.3712)
291 | [7] P. Wu, K. Wang, J. Zhang, and Q. Zhang, (2017) “Optimal Design for PID Controller
292 | Based on DE Algorithm in Omnidirectional Mobile Robot" MATEC Web of Conferences
293 | 95: 08014. DOI: 10.1051/matecconf/20179508014. (https://doi.org/10.1051/matecconf/20179508014)

294 | [8] S. Morales, J. Magallanes, C. Delgado, and R. Canahuire. “LQR Trajectory Tracking
295 | Control of an Omnidirectional Wheeled Mobile Robot”. In: 2018, 1–5. DOI: 10.1109/ (https://doi.org/10.1109/CCRA.2018.8588146)
296 | CCRA.2018.8588146. (https://doi.org/10.1109/CCRA.2018.8588146)
297 | [9] T. Zhang and X. Zhang, (2023) “Distributed Model Predictive Control with Particle Swarm
298 | Optimizer for Collision-Free Trajectory Tracking of MWMR Formation" Actuators 12: 127.
299 | DOI: 10.3390/act12030127. (https://doi.org/10.3390/act12030127)
300 | [10] C. Wang, X. Liu, X. Yang, F. Hu, A. Jiang, and C. Yang, (2018) “Trajectory Tracking of an
301 | Omni-Directional Wheeled Mobile Robot Using a Model Predictive Control Strategy" Applied
302 | Sciences 8: 231. DOI: 10.3390/app8020231. (https://doi.org/10.3390/app8020231)
303 | [11] D. Wang, W. Wei, Y. Yeboah, Y. Li, and Y. Gao, (2020) “A Robust Model Predictive Control
304 | Strategy for Trajectory Tracking of Omni-directional Mobile Robots" Journal of Intelligent
305 | Robotic Systems 98: DOI: 10.1007/s10846-019-01083-1. (https://doi.org/10.1007/s10846-019-01083-1)
306 | [12] I. Moreno, E. Celaya, and L. Ros, (2021) “Model Predictive Control for a Mecanum-wheeled
307 | Robot Navigating among Obstacles" IFAC-PapersOnLine 54: 119–125. DOI: 10.1016/j. (https://doi.org/10.1016/j.ifacol.2021.08.533)
308 | ifacol.2021.08.533. (https://doi.org/10.1016/j.ifacol.2021.08.533)
309 | [13] Z. Islam, S. Sahoo, M. Saad, U. Tople, and A. Khandare. “Robust Backstepping Con-
310 | troller for an Omniwheeled Mobile Robot with Uncertainties and External Distur-
311 | bances”. In: 2021, 35–42. DOI: 10.1007/978-981-15-3639-7_5. (https://doi.org/10.1007/978-981-15-3639-7_5)
312 | [14] L.-C. Lin and H.-Y. Shih, (2013) “Modeling and Adaptive Control of an Omni-Mecanum-
313 | Wheeled Robot" Intelligent Control and Automation 04: 166–179. DOI: 10.4236/ica. (https://doi.org/10.4236/ica.2013.42021)
314 | 2013.42021. (https://doi.org/10.4236/ica.2013.42021)

315 | [15] Z. Islam, S. Chiddarwar, and S. Sahoo. “Design of Robust Backstepping Controller for
316 | Four-Wheeled Mecanum Mobile Robot”. In: 2021, 1125–1134. DOI: 10.1007/978-981- (https://doi.org/10.1007/978-981-16-0550-5_107)
317 | 16-0550-5_107. (https://doi.org/10.1007/978-981-16-0550-5_107)
318 | [16] Z. Yuan, Y. Tian, Y. Yin, S. Wang, J. Liu, and L. Wu, (2020) “Trajectory Tracking Control of
319 | a Four Mecanum Wheeled Mobile Platform: an Extended State Observer-Based Sliding Mode
320 | Approach" IET Control Theory Applications 14: DOI: 10.1049/iet-cta.2018.6127. (https://doi.org/10.1049/iet-cta.2018.6127)
321 | [17] V. Alakshendra and S. Chiddarwar, (2017) “Adaptive robust control of Mecanum-wheeled
322 | mobile robot with uncertainties" Nonlinear Dynamics 87: DOI: 10.1007/s11071-016- (https://doi.org/10.1007/s11071-016-3179-1)
323 | 3179-1. (https://doi.org/10.1007/s11071-016-3179-1)
324 | [18] Z. Sun, H. Xie, J. Zheng, Z. Man, and D. He, (2020) “Path-Following Control of Mecanum-
325 | Wheels Omnidirectional Mobile Robots Using Nonsingular Terminal Sliding Mode" Mechani-
326 | cal Systems and Signal Processing: DOI: 10.1016/j.ymssp.2020.107128. (https://doi.org/10.1016/j.ymssp.2020.107128)
327 | [19] P. Bozek, Y. Karavaev, A. Ardentov, and K. Yefremov, (2020) “Neural network control of
328 | a wheeled mobile robot based on optimal trajectories" International Journal of Advanced
329 | Robotic Systems 17: DOI: 10.1177/1729881420916077. (https://doi.org/10.1177/1729881420916077)
330 | [20] M. Fliess and C. Join. “Intelligent PID controllers”. In: 2008, 326–331. DOI: 10.1109/MED. (https://doi.org/10.1109/MED.2008.4601995)
331 | 2008.4601995. (https://doi.org/10.1109/MED.2008.4601995)
332 | [21] M. Fliess and C. Join, (2013) “Model-free control" International Journal of Control 86:
333 | DOI: 10.1080/00207179.2013.810345. (https://doi.org/10.1080/00207179.2013.810345)
334 | [22] Y. Zhang, J. Jin, and L. Huang, (2020) “Model-Free Predictive Current Control of PMSM
335 | Drives Based on Extended State Observer Using Ultralocal Model" IEEE Transactions on
336 | Industrial Electronics PP: 1–1. DOI: 10.1109/TIE.2020.2970660. (https://doi.org/10.1109/TIE.2020.2970660)

337 | [23] T. Li and X. Liu, (2021) “Model-Free Non-Cascade Integral Sliding Mode Control of Permanent
338 | Magnet Synchronous Motor Drive with a Fast Reaching Law" Symmetry 13: 1680. DOI:
339 | 10.3390/sym13091680. (https://doi.org/10.3390/sym13091680)
340 | [24] J. Han, (2009) “From PID to Active Disturbance Rejection Control" Industrial Electronics,
341 | IEEE Transactions on 56: 900–906. DOI: 10.1109/TIE.2008.2011621. (https://doi.org/10.1109/TIE.2008.2011621)
342 | [25] Z. Gao. “Scaling and Parameterization Based Controller Tuning”. In: 6. 2003, 4989–4996.
343 | DOI: 10.1109/ACC.2003.1242516. (https://doi.org/10.1109/ACC.2003.1242516)
344 | [26] C.-C. Tsai and H.-L. Wu. “Nonsingular terminal sliding control using fuzzy wavelet
345 | networks for Mecanum wheeled omni-directional vehicles”. In: International Conference
346 | on Fuzzy Systems. 2010, 1–6. DOI: 10.1109/FUZZY.2010.5584223. (https://doi.org/10.1109/FUZZY.2010.5584223)
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
