GitHubLHAn/Final_DATN_LeHuuAn/Picture/Cấu trúc FOC truyền thống.png

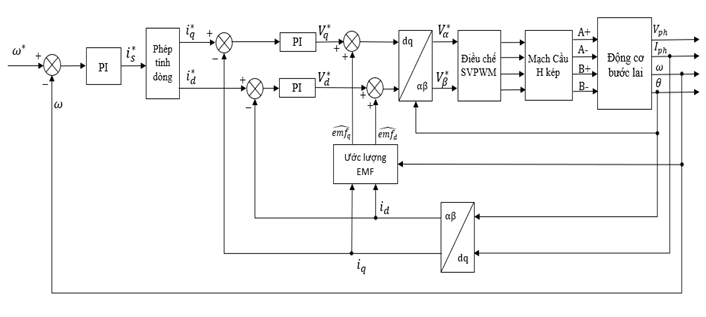
Picture/Cấu trúc FOC truyền thống.png
