GitHubLHAn/Final_DATN_LeHuuAn/Picture/Cấu trúc PI tốc độ theo chuẩn tối ưu module.png

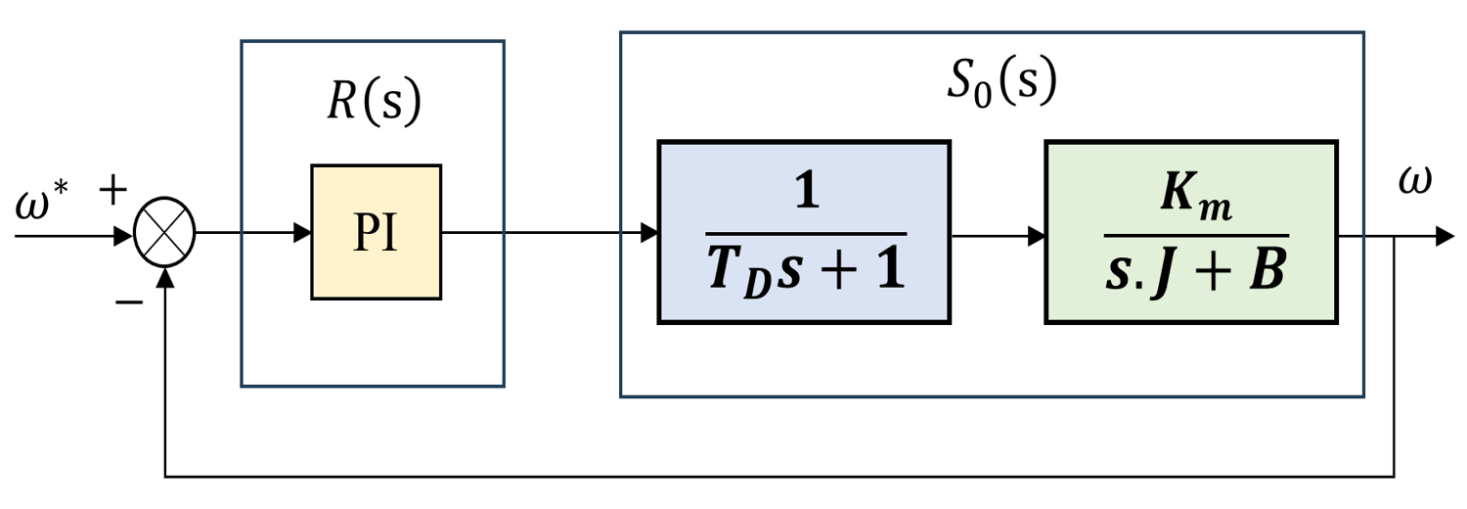
Picture/Cấu trúc PI tốc độ theo chuẩn tối ưu module.png
