GitHubLHAn/Final_DATN_LeHuuAn/Picture/Mô phỏng/KQ SVPWM dòng điện.png

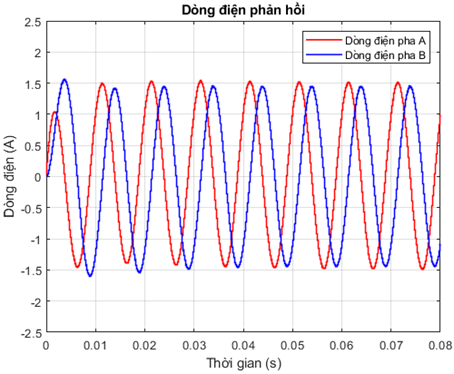
Picture/Mô phỏng/KQ SVPWM dòng điện.png
