GitHubLHAn/Final_DATN_LeHuuAn/Picture/Mô phỏng/KQ SVPWM T1 T2 T0.png

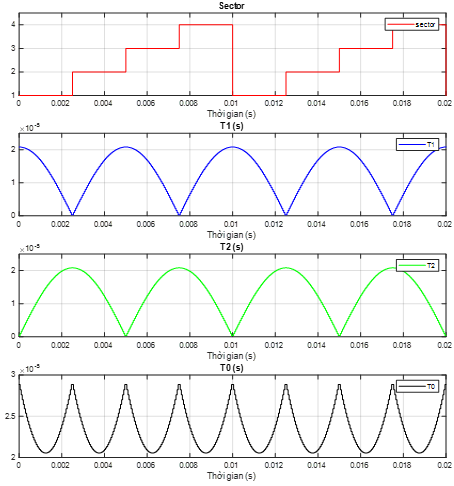
Picture/Mô phỏng/KQ SVPWM T1 T2 T0.png
