GitHubLHAn/Final_DATN_LeHuuAn/Picture/Sơ đồ tương đương bộ PLL.png

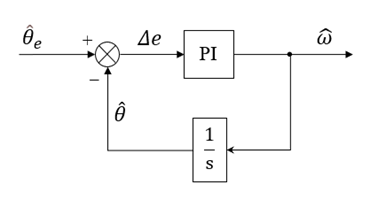
Picture/Sơ đồ tương đương bộ PLL.png
