GitHubLHAn/Final_DATN_LeHuuAn/Picture/Thực nghiệm/KQ mạch vòng dòng điện.png

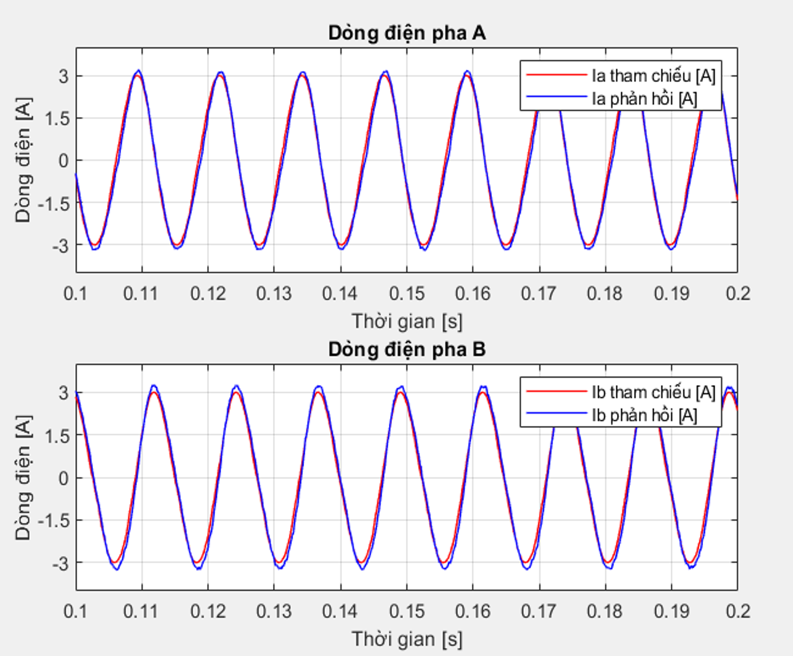
Picture/Thực nghiệm/KQ mạch vòng dòng điện.png
