GitHubLHAn/Final_DATN_LeHuuAn/Picture/Thực nghiệm/KQ PLL cho góc từ thông.png

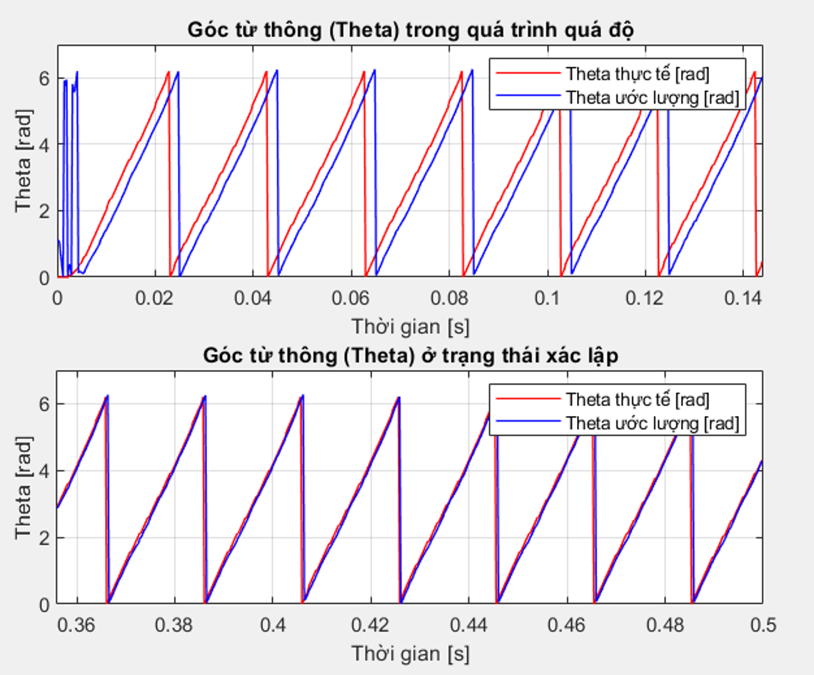
Picture/Thực nghiệm/KQ PLL cho góc từ thông.png
