GitHubLHAn/Final_DATN_LeHuuAn/Picture/Thực nghiệm/KQ vòng tốc độ khi quá độ.png

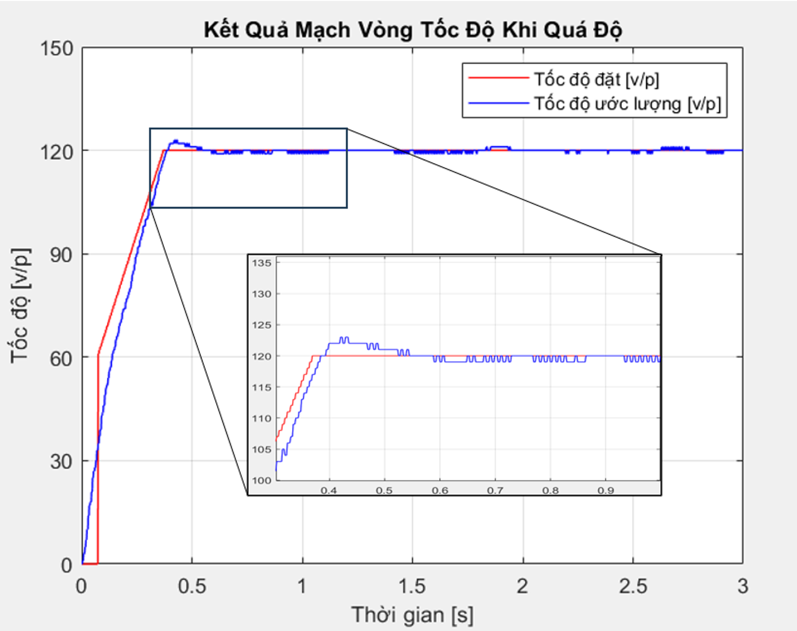
Picture/Thực nghiệm/KQ vòng tốc độ khi quá độ.png
