GitHubLHAn/Final_DATN_LeHuuAn/Picture/Thực nghiệm/KQ vòng tốc độ khi thay đổi momen.png

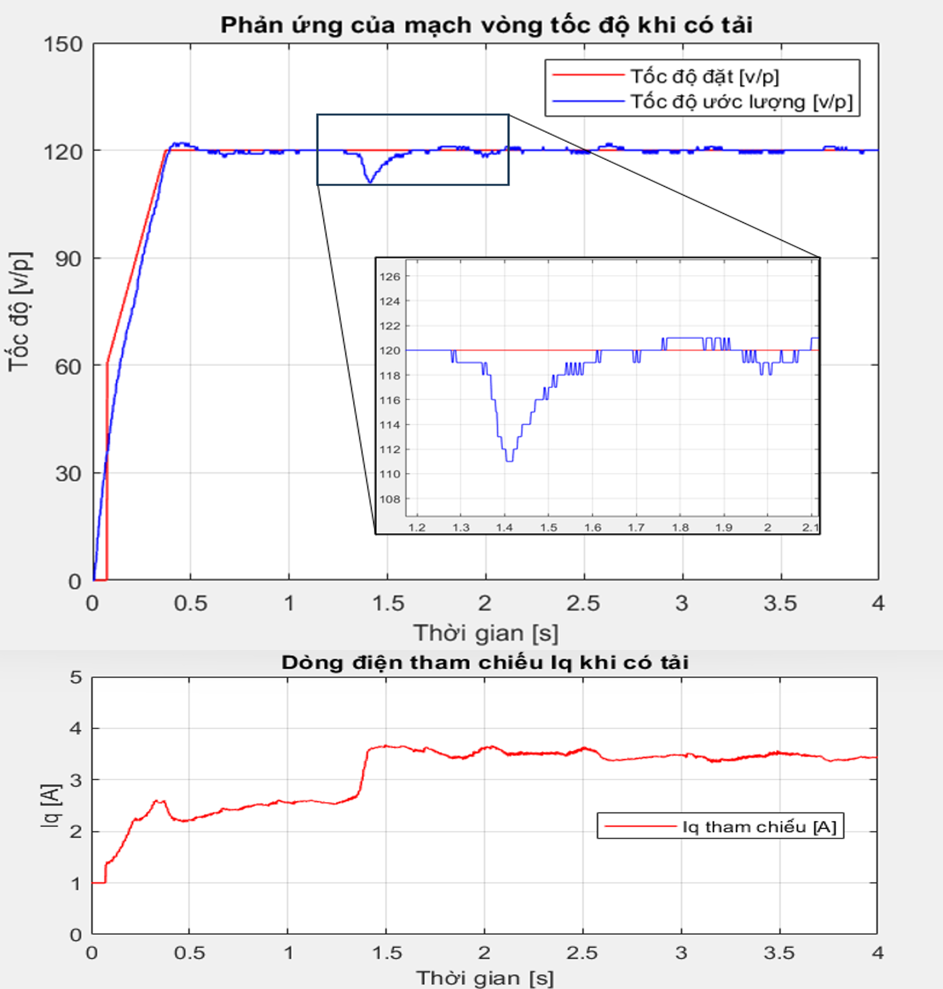
Picture/Thực nghiệm/KQ vòng tốc độ khi thay đổi momen.png
