GitHubLHAn/Final_DATN_LeHuuAn/Picture/Thực nghiệm/Sdnl khối encoder.png

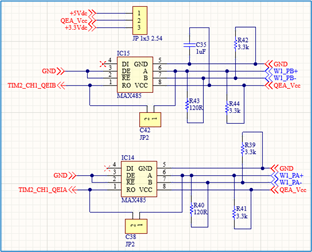
Picture/Thực nghiệm/Sdnl khối encoder.png
