GitHubLHAn/Final_DATN_LeHuuAn/Picture/Thực nghiệm/Sdnl khối đo dòng.png

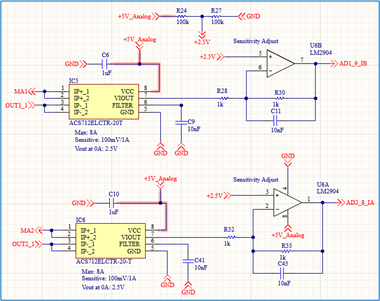
Picture/Thực nghiệm/Sdnl khối đo dòng.png
