GitHubLHAn/Final_DATN_LeHuuAn/Picture/Thực nghiệm/Sdnl khối đo áp.png

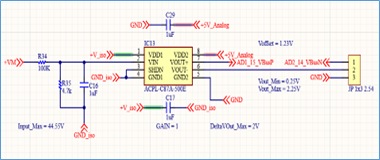
Picture/Thực nghiệm/Sdnl khối đo áp.png
