GitHubLHAn/Final_DATN_LeHuuAn/Picture/Thực nghiệm/Sơ đồ nguyên lý khối nguồn.png

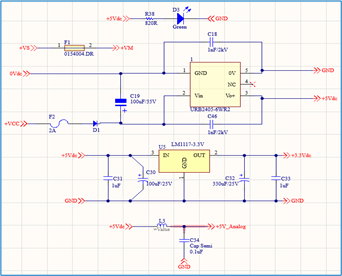
Picture/Thực nghiệm/Sơ đồ nguyên lý khối nguồn.png
