GitHubLHAn/Final_DATN_LeHuuAn/Picture/Thực nghiệm/Video demo.png

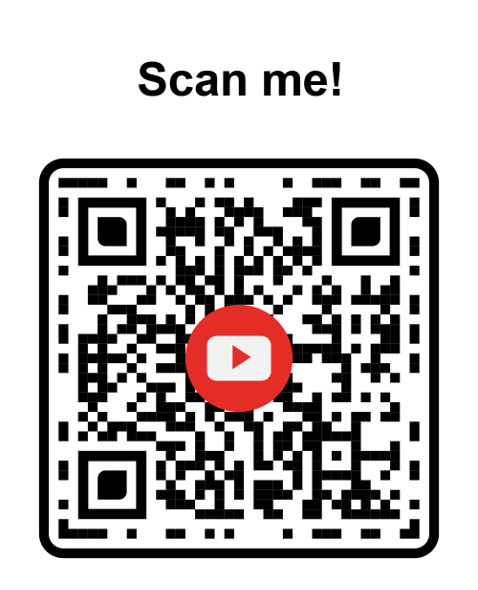
Picture/Thực nghiệm/Video demo.png
