GitHubLHAn/Final_DATN_LeHuuAn/Project/Simulation_Matlab/Du_lieu_thuc_nghiem/theta.png

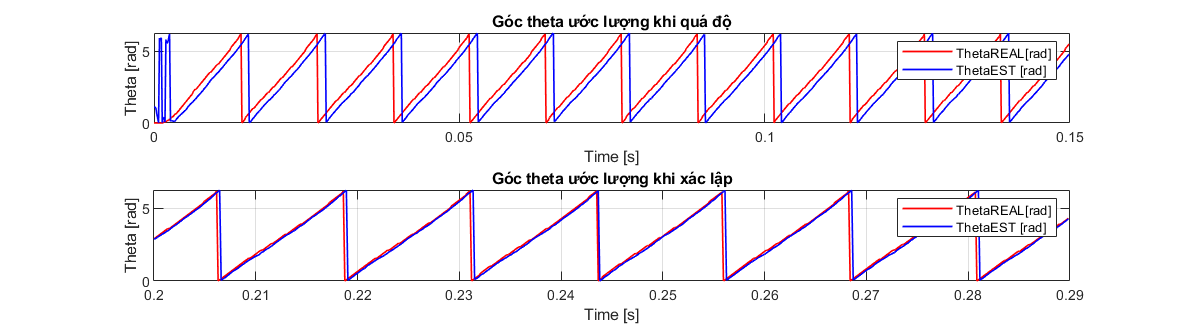
Project/Simulation_Matlab/Du_lieu_thuc_nghiem/theta.png
