GitHubLHAn/Final_DATN_LeHuuAn/Project/Hardware/Hardware_SupportBoard/MainBoard.pdf

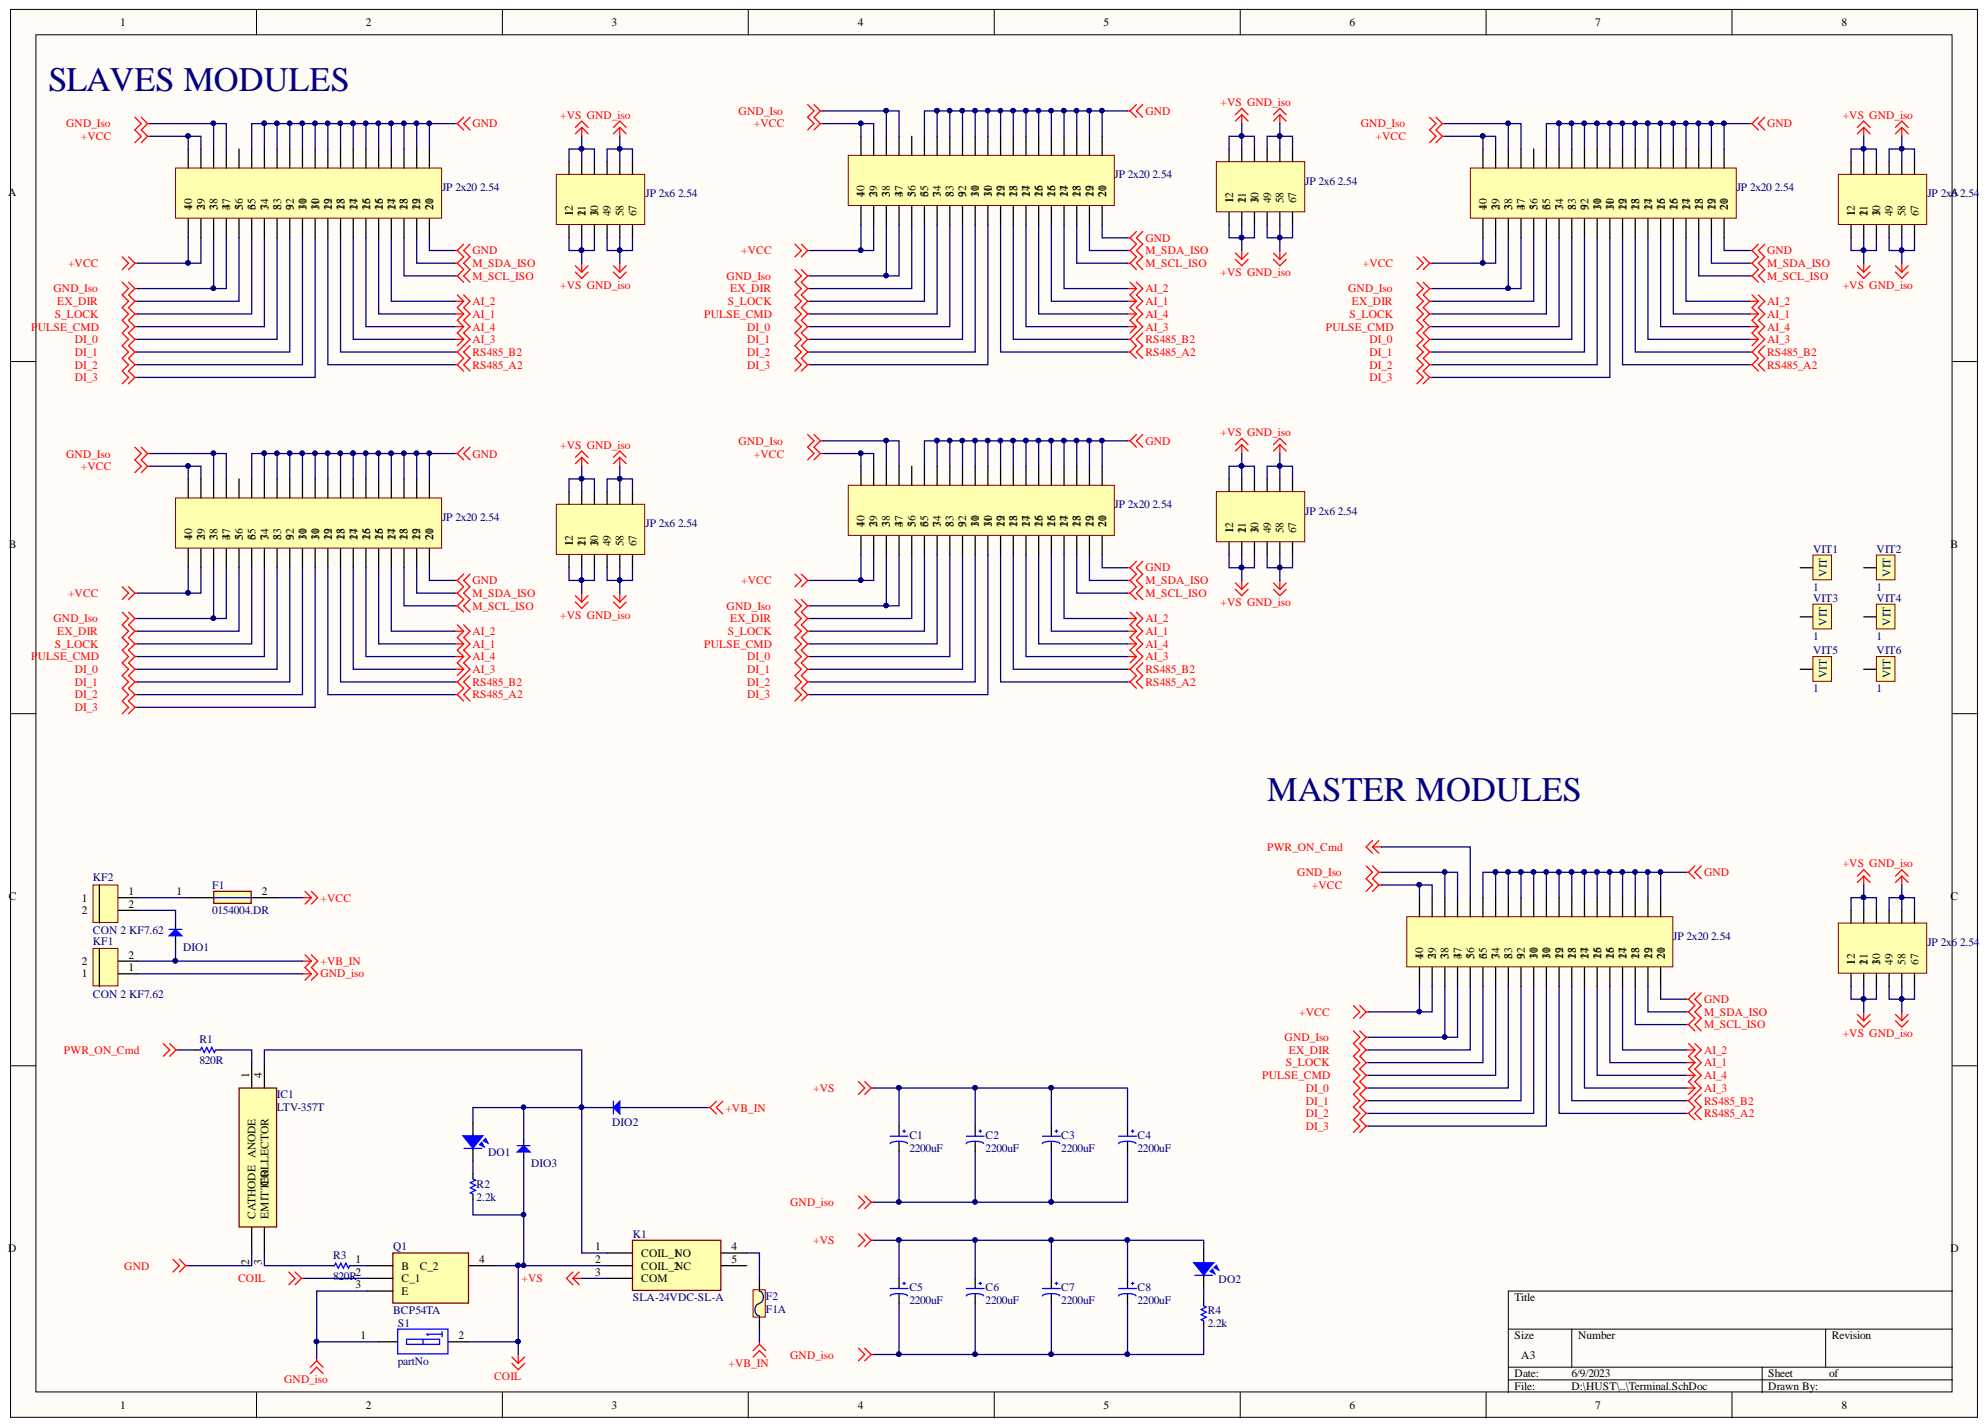
[picture p116: page 1]
