GitHubLHAn/Final_DATN_LeHuuAn/(list of files, drawings)

Other design files:
Project/Hardware/Hardware_SupportBoard/MainBoard.PrjPCB
Project/Hardware/Hardware_SupportBoard/PCB_Mainboard.PcbDoc
Project/Hardware/Hardware_SupportBoard/Terminal.SchDoc
Project/Hardware/Slave_STM32F405RGT6_Isolated_PS_V20Sep23/5A_FOC_HybridStepperDrive.PrjPCB
Project/Hardware/Slave_STM32F405RGT6_Isolated_PS_V20Sep23/Communication.SchDoc
Project/Hardware/Slave_STM32F405RGT6_Isolated_PS_V20Sep23/Current_Sense.SchDoc
Project/Hardware/Slave_STM32F405RGT6_Isolated_PS_V20Sep23/DI_DO_AI_AO.SchDoc
Project/Hardware/Slave_STM32F405RGT6_Isolated_PS_V20Sep23/MC33886_PowerModule.SchDoc
Project/Hardware/Slave_STM32F405RGT6_Isolated_PS_V20Sep23/MCU_STM32L433RCT6.SchDoc
Project/Hardware/Slave_STM32F405RGT6_Isolated_PS_V20Sep23/Power_Supply.SchDoc
Project/Hardware/Slave_STM32F405RGT6_Isolated_PS_V20Sep23/QEA_Interface.SchDoc
Project/Hardware/Slave_STM32F405RGT6_Isolated_PS_V20Sep23/Terminal.SchDoc
