GitHubLHAn/Final_DATN_LeHuuAn/Code versions/Code_ver1/Core/Src/main.c

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
/* Includes ------------------------------------------------------------------*/
#include "main.h"

/* USER CODE BEGIN Includes */
#include "stdio.h"
#include <math.h>
/* USER CODE END Includes */

ADC_HandleTypeDef hadc1;
ADC_HandleTypeDef hadc2;
DMA_HandleTypeDef hdma_adc1;

CAN_HandleTypeDef hcan1;

I2C_HandleTypeDef hi2c1;
I2C_HandleTypeDef hi2c2;

TIM_HandleTypeDef htim1;
TIM_HandleTypeDef htim2;
TIM_HandleTypeDef htim3;
TIM_HandleTypeDef htim5;

UART_HandleTypeDef huart3;

void SystemClock_Config(void);
static void MX_GPIO_Init(void);
static void MX_DMA_Init(void);
static void MX_ADC1_Init(void);
static void MX_ADC2_Init(void);
static void MX_CAN1_Init(void);
static void MX_I2C1_Init(void);
static void MX_I2C2_Init(void);
static void MX_TIM1_Init(void);
static void MX_TIM2_Init(void);
static void MX_USART3_UART_Init(void);
static void MX_TIM3_Init(void);
static void MX_TIM5_Init(void);
/* USER CODE BEGIN 0 */
		/*Khai bao bien*/
		ENCODER_OBJECT encoder_var, theta_var;
		PI_OBJECT PI_Id_var, PI_Iq_var, PI_speed_var;  
		ADC_OBJECT adc_var;
		HSM hsm_var; 			// hybrid stepper motor variable
		FLAG flag_var;
		CONTROL_OBJECT control_var;
		SVPWM svpwm_var;
		LPF LPF_speed_var, LPF_current_var, LPF_voltage_var;
		UART uart_var;
		
		volatile float put_rpm = 0, put_Iq = 0;
		
		uint8_t MSG[20] = {'\0'};	
		
		void Wait_time(float time){
			static volatile uint16_t getdata = 0;
			if (getdata < time){  
				getdata++;						// get data after 1s
			}
			if(getdata == time){
				if(control_var.cnt_k == 0){
					flag_var.flag_read = 1;
					getdata = time+1; 
					Motor_Enable();
				}
			}
		}
		
		void SAVE_DATA(TYPE data){
			static volatile uint16_t cnt_data = 0;
			if(cnt_data < 100){
				if(data == CURRENT){
					uart_var.data_1[cnt_data] = (int)(1000*control_var.Iq_sp); //(int)(control_var.dutyA);//  //(int)(1000*control_var.Id_sp);
					uart_var.data_2[cnt_data] = (int)(1000*control_var.Iq_fb); //(int)(control_var.dutyB);  //(int)(1000*control_var.Id_fb);
					uart_var.data_3[cnt_data] = (int)(1000*control_var.Id_sp);
					uart_var.data_4[cnt_data] = (int)(1000*control_var.Id_fb);
				}
				if(data == SPEED){
					uart_var.data_1[cnt_data] = (int)(100*control_var.rpm_sp);
					uart_var.data_2[cnt_data] = (int)(100*encoder_var.rpm_fb);
				}
				cnt_data++;			// next sample
			}
			else{
				Motor_stop();
				flag_var.flag_send = 1;		// start sending
				flag_var.flag_read = 0;			// stop reading	
			}					
		}
		/*HAM NGAT TIMER********************************************/
		void HAL_TIM_PeriodElapsedCallback(TIM_HandleTypeDef *htim){
			/* Prevent unused argument(s) compilation warning */
			UNUSED(htim);
			/*USER CODE*/
			
				if (htim->Instance == htim1.Instance){			// interrupt every 25us		
					/*Let comment the Wait_time when run OPEN LOOP*/
					Wait_time(40000);	// wait a second to start running the motor
					
					/*Current loop execute below*/
					flag_var.flag_25us_50us++;
					if(flag_var.flag_25us_50us >= 2){			// every 50us						
						CAL_CURRENT(&adc_var);
						//CURRENT_OPENLOOP(&control_var, &adc_var, 12);			// set the voltage
						flag_var.flag_25us_50us = 0;
				
						if(flag_var.flag_read == 1){				// start read and save data		
							CURRENT_LOOP(&control_var, &PI_Id_var, &PI_Iq_var); //set the current Iq								
							//SAVE_DATA(CURRENT);		
						}
					}
					
					/*Speed loop*/
					flag_var.flag_25us_20ms++;					
					if(flag_var.flag_25us_20ms >= 200){				// every 20ms 
						CAL_SPEED(&encoder_var);
						//SPEED_LOOP(&control_var, &PI_speed_var, 120);		// set the speed rpm
								
						flag_var.flag_25us_20ms = 0;
						if(flag_var.flag_read == 1){				// start read and save data		
							SPEED_LOOP(&control_var, &PI_speed_var, 120);
							SAVE_DATA(SPEED);		
						}
					}
				}
		}
		/*Blink Leds********************************************/
		void nhayled(uint16_t ms){
			HAL_GPIO_TogglePin(LED1_GPIO_Port, LED1_Pin);
			HAL_GPIO_TogglePin(LED2_GPIO_Port, LED2_Pin);
			delay_ms(ms);
		}
			/* USER CODE END 0 */

/**
  * @brief  The application entry point.
  * @retval int
  */
int main(void)
{
  /* MCU Configuration--------------------------------------------------------*/

  /* Reset of all peripherals, Initializes the Flash interface and the Systick. */
  HAL_Init();

  /* Configure the system clock */
  SystemClock_Config();

  /* Initialize all configured peripherals */
  MX_GPIO_Init();
  MX_DMA_Init();
  MX_ADC1_Init();
  MX_ADC2_Init();
  MX_CAN1_Init();
  MX_I2C1_Init();
  MX_I2C2_Init();
  MX_TIM1_Init();
  MX_TIM2_Init();
  MX_USART3_UART_Init();
  MX_TIM3_Init();
  MX_TIM5_Init();
  /* USER CODE BEGIN 2 */			
		HAL_GPIO_WritePin(LED1_GPIO_Port, LED1_Pin, GPIO_PIN_SET);		// 	disable led 1
		HAL_GPIO_WritePin(LED2_GPIO_Port, LED2_Pin, GPIO_PIN_SET);		//  disable led 2
		HAL_GPIO_WritePin(PWM_EN1_GPIO_Port, PWM_EN1_Pin, GPIO_PIN_RESET);		// disable H bridge 1 
		HAL_GPIO_WritePin(PWM_EN2_GPIO_Port, PWM_EN2_Pin, GPIO_PIN_RESET);		// disable H bridge 1
	
		// BAT CHE DO PHAT XUNG PWM 2 KENH
		HAL_TIM_PWM_Start(&htim1, TIM_CHANNEL_1);
		HAL_TIMEx_PWMN_Start(&htim1, TIM_CHANNEL_1);
		HAL_TIM_PWM_Start(&htim1, TIM_CHANNEL_2);
		HAL_TIMEx_PWMN_Start(&htim1, TIM_CHANNEL_2);

				
		// START ADC
		HAL_ADC_Start(&hadc1);

		// CONFIG TIMER
		HAL_TIM_Base_Start_IT(&htim1); 			// PWM & control loop
		HAL_TIM_Base_Start_IT(&htim2); 			// Encoder
		HAL_TIM_Base_Start(&htim3); 		 		//	counter timer - delay timer (not used yet)
		HAL_TIM_Base_Start(&htim5); 		 		//	counter timer - delay timer (not used yet)
		//HAL_TIM_Encoder_Start_IT(&htim2, TIM_CHANNEL_ALL);
		HAL_TIM_Encoder_Start(&htim2, TIM_CHANNEL_ALL);			// Encoder on htim 2
		//HAL_UART_Receive_IT(&huart3, &uart_var.data_RX, 1);
				
		// INIT FUNCTIONS
		MOTOR_Init(&hsm_var);
		
		FLAG_Init(&flag_var);
		ADC_Init(&adc_var);
		ENCODER_Init(&encoder_var, 1000, 4, 5e-3);			// use for cal the speed
		ENCODER_Init(&theta_var, 1000, 4, NULL);		// use for count the received pulse, then cal the theta mechanical (rad)
		
		CONTROLLER_Init(&control_var, 50e-6);			/*CONTROLLER_Init(control var, Ts);*/ 
		SVPWM_Init(&svpwm_var);
		
		LPF_Init(&LPF_current_var, 1000, 0.0001);
		LPF_Init(&LPF_speed_var, 10, 0.01);
		LPF_Init(&LPF_voltage_var, 10, 0.01);
		
		PI_CURRENT_Init(&PI_Id_var, 50e-6);
		PI_CURRENT_Init(&PI_Iq_var, 50e-6);
		PI_SPEED_Init(&PI_speed_var, 5e-3);
		
		UART_Init(&uart_var);
		
		/*Enable the motor to hold rotor on phase A*/
		Motor_Enable();
		//htim1.Instance->CCR1 = 2500;
		//htim1.Instance->CCR2 = 2100;
		//Motor_stop();
		
		HAL_GPIO_WritePin(RS485_EN3_GPIO_Port, RS485_EN3_Pin, GPIO_PIN_SET);		// Set the transmit mode for IC RS485		
  /* USER CODE END 2 */

  /* Infinite loop */
  /* USER CODE BEGIN WHILE */
  while (1)
  { 
    /* USER CODE END WHILE */

    /* USER CODE BEGIN 3 */
			
		if(flag_var.flag_send == 1){
			if(uart_var.cnt < 100){
				sprintf((char*)MSG,"\n%d %d %d %d %d", uart_var.data_1[uart_var.cnt],uart_var.data_2[uart_var.cnt],
																							uart_var.data_3[uart_var.cnt],uart_var.data_4[uart_var.cnt],uart_var.cnt);
				HAL_UART_Transmit(&huart3, (uint8_t *)MSG, sizeof(MSG), 100);
				uart_var.cnt++;
				//HAL_Delay(10);
			}
			else{
				flag_var.flag_send = 0; 
				//HAL_GPIO_WritePin(LED1_GPIO_Port, LED1_Pin, GPIO_PIN_RESET);			// inform the sending data is done
				HAL_UART_Transmit(&huart3, (uint8_t *)"\nE0,E0,E0;", sizeof("\nE0,E0,E0;"), 30);		// stop frame
			}
		}
		
		
		/*---------------------------Used for test few modes------------------------------------------*/
		
		/*MODE TEST 1 - 1 up, 2 up*/
//		if(HAL_GPIO_ReadPin(ADDR_0_GPIO_Port, ADDR_0_Pin)==0 && HAL_GPIO_ReadPin(ADDR_1_GPIO_Port, ADDR_1_Pin)==0){
//			put_rpm = 30;
//		}
//		
//		/*MODE TEST 2 - 1 down, 2 up*/
//		if(HAL_GPIO_ReadPin(ADDR_0_GPIO_Port, ADDR_0_Pin)==1 && HAL_GPIO_ReadPin(ADDR_1_GPIO_Port, ADDR_1_Pin)==0){
//			put_rpm = 60;
//		}
//		
//		/*MODE TEST 2 - 1 down, 2 down*/
//		if(HAL_GPIO_ReadPin(ADDR_0_GPIO_Port, ADDR_0_Pin)==1 && HAL_GPIO_ReadPin(ADDR_1_GPIO_Port, ADDR_1_Pin)==1){
//			put_rpm = 120;
//		}
//		
//		/*MODE TEST 2 - 1 up, 2 down*/
//		if(HAL_GPIO_ReadPin(ADDR_0_GPIO_Port, ADDR_0_Pin)==0 && HAL_GPIO_ReadPin(ADDR_1_GPIO_Port, ADDR_1_Pin)==1){
//			put_rpm = 150;
//		}
		
	 
  }
  /* USER CODE END 3 */
}

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
