GitHubLHAn/Final_DATN_LeHuuAn/Code versions/Driver_HSM_ver3/Core/Inc/main.h

#define ADDR_0_Pin GPIO_PIN_13
#define ADDR_0_GPIO_Port GPIOC
#define ADDR_1_Pin GPIO_PIN_14
#define ADDR_1_GPIO_Port GPIOC
#define ADDR_2_Pin GPIO_PIN_15
#define ADDR_2_GPIO_Port GPIOC
#define ADC_15_Vbus_Pin GPIO_PIN_5
#define ADC_15_Vbus_GPIO_Port GPIOC
#define ADC_8_Ia_Pin GPIO_PIN_0
#define ADC_8_Ia_GPIO_Port GPIOB
#define ADC_9_Ib_Pin GPIO_PIN_1
#define ADC_9_Ib_GPIO_Port GPIOB
#define DI_0_Pin GPIO_PIN_12
#define DI_0_GPIO_Port GPIOB
#define PWM_EN2_Pin GPIO_PIN_15
#define PWM_EN2_GPIO_Port GPIOB
#define DI_1_Pin GPIO_PIN_6
#define DI_1_GPIO_Port GPIOC
#define DI_2_Pin GPIO_PIN_7
#define DI_2_GPIO_Port GPIOC
#define DI_3_Pin GPIO_PIN_8
#define DI_3_GPIO_Port GPIOC
#define PWM_EN1_Pin GPIO_PIN_9
#define PWM_EN1_GPIO_Port GPIOC
#define RS485_EN3_Pin GPIO_PIN_12
#define RS485_EN3_GPIO_Port GPIOC
#define LED1_Pin GPIO_PIN_3
#define LED1_GPIO_Port GPIOB
#define LED2_Pin GPIO_PIN_4
#define LED2_GPIO_Port GPIOB
#define ADDR_3_Pin GPIO_PIN_5
#define ADDR_3_GPIO_Port GPIOB
#define PI 3.1416
#define GAIN_W	9.5473   // transfer rpm to rad/s
#define CCW 0    //counter-clock-wise
#define CW 1		// clock-wise
