GitHubLHAn/Final_DATN_LeHuuAn/Code versions/Version5_HSM/Core/Src/UART.c

#include "main.h"
#include "stm32f4xx_hal_tim.h"
#include "stdio.h"
#include <math.h>

extern TIM_HandleTypeDef htim1;

extern UART_HandleTypeDef huart3;
extern UART uart_var;
extern CONTROL_OBJECT control_var;
extern ENCODER_OBJECT encoder_var;
extern StateMachine vStateMa;
extern RAMP ramp_rpm_var;
extern ADC_OBJECT adc_var;
extern SMC SMC_var;

uint8_t MSG[30] = {'\0'};

/*_________________________________________________________________________________________________________________________*/
	/*Initiate data*/
	void UART_Init(UART *pUART){
		for(int i=0; i<2000; i++)
		{			
			pUART->data_1[i] = 0;
			pUART->data_2[i] = 0;
			pUART->data_3[i] = 0;
			pUART->data_4[i] = 0;
		}
		pUART->saving = 0;
		pUART->save_done = 0;
		pUART->sending = 0;
		pUART->cnt = 0;
		pUART->num_data = 0;
		pUART->start = 0;
		
		HAL_GPIO_WritePin(RS485_EN3_GPIO_Port, RS485_EN3_Pin, GPIO_PIN_SET);		// Set the transmit mode for IC RS485	
	}	
/*_________________________________________________________________________________________________________________________*/
	void SAVE_DATA(mDATA get_mode)
	{
		if(get_mode == GET_C_DATA && uart_var.saving == 1)		// get current value
		{
			uart_var.num_data = 2000;
			if(uart_var.cnt < uart_var.num_data)
			{
//				uart_var.data_1[uart_var.cnt] = (int)(1000*SMC_var.theta_real); 		
//				uart_var.data_2[uart_var.cnt] = (int)(1000*SMC_var.theta_est); 		
				//uart_var.data_3[uart_var.cnt] = (int)(1000*SMC_var.Ibk_ref);
				//uart_var.data_4[uart_var.cnt] = (int)(1000*adc_var.Ib_fb);
				
				// lay Iq_ref va Ia Ib feedback
//				uart_var.data_1[uart_var.cnt] = (int)(1000*SMC_var.Iq_ref); 		
//				uart_var.data_2[uart_var.cnt] = (int)(1000*adc_var.Ia_fb); 		
//				uart_var.data_3[uart_var.cnt] = (int)(1000*adc_var.Ib_fb);
				
				// ia_ref va Ia fb
//				uart_var.data_1[uart_var.cnt] = (int)(1000*SMC_var.Iak_ref); 		
//				uart_var.data_2[uart_var.cnt] = (int)(1000*adc_var.Ia_fb);
				
				// ib_ref va Ib fb
//				uart_var.data_1[uart_var.cnt] = (int)(1000*SMC_var.Ibk_ref); 		
//				uart_var.data_2[uart_var.cnt] = (int)(1000*adc_var.Ib_fb);
				
//				uart_var.data_1[uart_var.cnt] = (int)(SMC_var.RPM_sp); 		
//				uart_var.data_2[uart_var.cnt] = (int)(encoder_var.rpm_fb);
//				uart_var.data_3[uart_var.cnt] = (int)(1000*SMC_var.Iq_ref);

				uart_var.data_1[uart_var.cnt] = (int)(encoder_var.rpm_fb); 		
				uart_var.data_2[uart_var.cnt] = (int)(SMC_var.rpm_fb_est);
				
				uart_var.cnt++;
			}
			else uart_var.save_done = 1;
		}
		/*-----------------------------*/
		if(get_mode == GET_S_DATA && uart_var.saving == 1)		// get speed value
		{		
			uart_var.num_data = 1000;
			if(uart_var.cnt < uart_var.num_data)
			{
				uart_var.data_1[uart_var.cnt] = (int)(100*control_var.rpm_sp);
				uart_var.data_2[uart_var.cnt] = (int)(100*encoder_var.rpm_fb);
				uart_var.data_3[uart_var.cnt] = (int)(100*control_var.theta_e);
				uart_var.data_4[uart_var.cnt] = 0;
				uart_var.cnt++;
			}
			else uart_var.save_done = 1;
		}
		/*-----------------------------*/
		if(get_mode == GET_P_DATA && uart_var.saving == 1)
		{		// get position value
		
		}
		/*-----------------------------*/
		if(uart_var.save_done == 1 && uart_var.saving == 1)
		{
			//HAL_TIM_Base_Stop_IT(&htim1);
			uart_var.saving = 0;
			uart_var.cnt = 0;
			uart_var.sending = 1;
			//Motor_Disable();
			HAL_TIM_Base_Stop_IT(&htim1);
			HAL_GPIO_WritePin(LED1_GPIO_Port, LED2_Pin, GPIO_PIN_RESET);
			htim1.Instance->CCR1 = (int)(8400*0.65f);		
			htim1.Instance->CCR2 = (int)(8400*(1.0f - 0.65f));
			htim1.Instance->CCR3 = (int)(8400*0.5f);		
			htim1.Instance->CCR4 = (int)(8400*(1.0f - 0.5f));
		}
	}
/*_________________________________________________________________________________________________________________________*/
	/*Send_data*/
	void SEND_DATA(void)
	{
		if(uart_var.sending == 1)
		{
			if(uart_var.cnt < uart_var.num_data)
			{
				sprintf((char*)MSG,"\n%d %d %d %d %d", uart_var.data_1[uart_var.cnt],uart_var.data_2[uart_var.cnt],
																							uart_var.data_3[uart_var.cnt],uart_var.data_4[uart_var.cnt],uart_var.cnt);
//				sprintf((char*)MSG,"\n%d %d %d %d", uart_var.data_1[uart_var.cnt],uart_var.data_2[uart_var.cnt],
//																							uart_var.data_3[uart_var.cnt],uart_var.data_4[uart_var.cnt]);
				HAL_UART_Transmit(&huart3, (uint8_t *)MSG, sizeof(MSG), 100);		
				uart_var.cnt++;
			}
			else
			{
				uart_var.sending = 0;
				HAL_UART_Transmit(&huart3, (uint8_t *)"\nDone!!!", sizeof("\nDone!!!"), 30);	
			}				
		}
	}

	
	
	
	
//				if (htim->Instance == htim1.Instance)		// interrupt every 25us
//				{			
//					if(control_var.Iq_fb > 5.5f)
//					{		Motor_Disable();
//							HAL_GPIO_WritePin(LED2_GPIO_Port, LED2_Pin, GPIO_PIN_RESET);		//error
//					}
//					
//					/*------------------------------------------------------------------------*/
//					flag_var.flag_25us_50us++;
//					if(flag_var.flag_25us_50us >= 2)
//					{			// every 50us		
//						flag_var.flag_25us_50us = 0;						
//						CAL_CURRENT(&adc_var);
//						STATE_MACHINE_HANDLE();
//					}	
//					
//					flag_var.flag_25us++;
//					if(flag_var.flag_25us >= 40){			// every 	
//						flag_var.flag_25us = 0;						
//						//SAVE_DATA(GET_C_DATA);
//						//SAVE_DATA(GET_S_DATA);	
//					}	
//				}

//				if (htim->Instance == htim3.Instance)		// interrupt every 1ms
//				{	
//					if(mState_var.mSTATE == mRUN && mState_var.mCONTROL_MODE == CLOSE_LOOP_SPD)
//					{
//						flag_var.flag_1ms_20ms++;
//						if(flag_var.flag_1ms_20ms >= 20)  // every 20ms
//						{		
//							flag_var.flag_1ms_20ms = 0;
//							CAL_SPEED(&encoder_var);			
//							SPEED_LOOP(&control_var, &PI_speed_var, 120);
//							HAL_GPIO_TogglePin(LED1_GPIO_Port, LED1_Pin);
//						}
//					}				
//				}
		
