GitHubLHAn/Final_DATN_LeHuuAn/Project/Simulation_Matlab/MCU_Stm32_wrapper.c

/*
 * Include Files
 *
 */
#if defined(MATLAB_MEX_FILE)
#include "tmwtypes.h"
#include "simstruc_types.h"
#else
#include "rtwtypes.h"
#endif



/* %%%-SFUNWIZ_wrapper_includes_Changes_BEGIN --- EDIT HERE TO _END */
#include <math.h>
/* %%%-SFUNWIZ_wrapper_includes_Changes_END --- EDIT HERE TO _BEGIN */
#define y_width 3

/*
 * Create external references here.  
 *
 */
/* %%%-SFUNWIZ_wrapper_externs_Changes_BEGIN --- EDIT HERE TO _END */
/* extern double func(double a); */
/* %%%-SFUNWIZ_wrapper_externs_Changes_END --- EDIT HERE TO _BEGIN */

/*
 * Output function
 *
 */
void MCU_Stm32_Outputs_wrapper(real_T *m)
{
/* %%%-SFUNWIZ_wrapper_Outputs_Changes_BEGIN --- EDIT HERE TO _END */
/* This sample sets the output equal to the input
      y0[0] = u0[0]; 
 For complex signals use: y0[0].re = u0[0].re; 
      y0[0].im = u0[0].im;
      y1[0].re = u1[0].re;
      y1[0].im = u1[0].im;
 */
/* %%%-SFUNWIZ_wrapper_Outputs_Changes_END --- EDIT HERE TO _BEGIN */
}
