GitHubLHAn/Final_DATN_LeHuuAn/(commit log)

2024-07-29 The first time update - 29/7/24
    [5A_FOC_HybridStepperDrive.PrjPCB, Communication.SchDoc, Current_Sense.SchDoc, DI_DO_AI_AO.SchDoc, MC33886_PowerModule.SchDoc, MCU_STM32L433RCT6.SchDoc, MainBoard.PrjPCB, PCB_Mainboard.PcbDoc]
2024-07-29 Sua lai cau truc folder - 29/7/24
    [5A_FOC_HybridStepperDrive.PrjPCB, Communication.SchDoc, Current_Sense.SchDoc, DI_DO_AI_AO.SchDoc, MC33886_PowerModule.SchDoc, MCU_STM32L433RCT6.SchDoc, MainBoard.PrjPCB, PCB_Mainboard.PcbDoc]
